NJIT-Solar-Car/canio/README.md

# CAN IO Board Development

# The CAN I/O driver board will allow the Central Control Unit to switch on and off various electronics over the vehicle’s CAN bus.
