NJIT-Solar-Car/canio/docs/DesignNotes.md

# CAN-IO Board Hardware/Firmware Development

- [Main Github][01]

## Fabrication notes

- Board is 4 layer, 100mm\*100mm
- It should be set to 1.6mm, using the FR4 TG135 (default) core, and JLC04161H-7628 stackup from JLCPCB.
- Outer copper weight should be *1oz* and inner copper weight *0.5oz* (not the 2oz and 1oz which the design centered around earlier). This allows a maximum **2A current draw** from each output channel.
- If possible, order the stencil as well
- Use DHL or FedEx shipping, the Global standard direct line is cheap but takes upwards of 2 weeks for shipping alone.
- Rough total, including stencil, board, shipping, and tariffs should be **~$50-70**.

<!-- Links -->
[01]: https://github.com/NJIT-Solar-Car/can-io-board
