NJIT-Solar-Car/canio/assets/CubeMX_Config.png

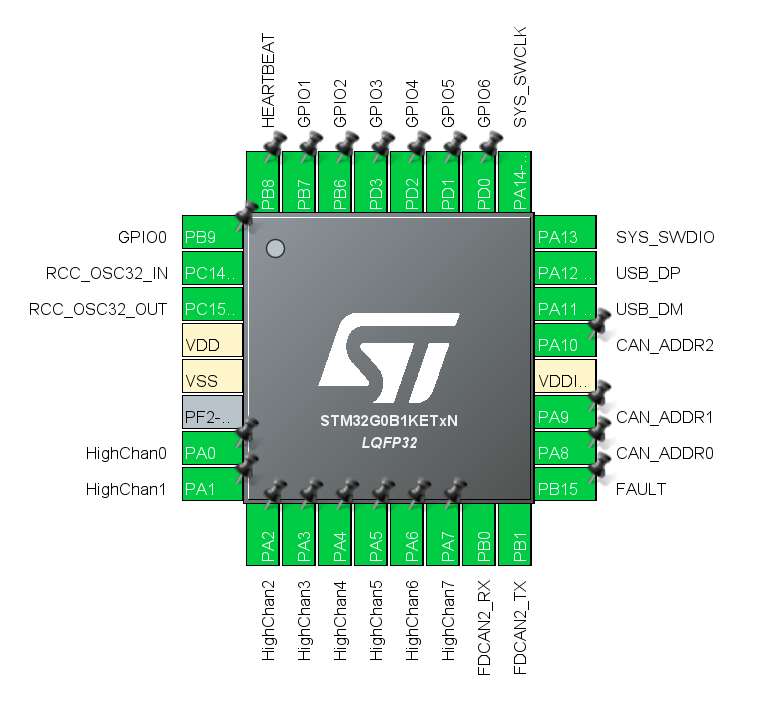
assets/CubeMX_Config.png
