NJIT-Solar-Car/canio/assets/relay_board_v1.png

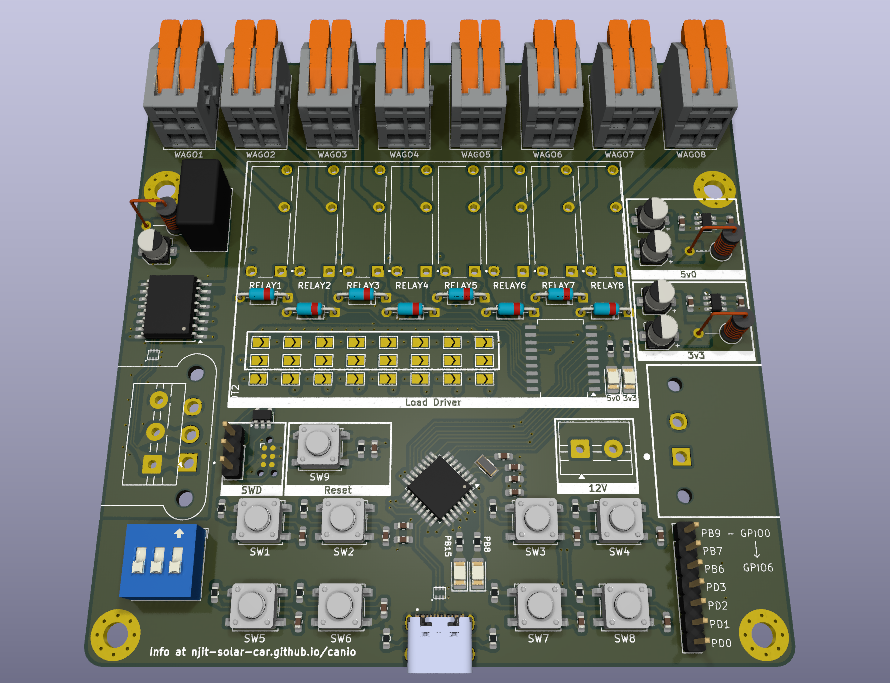
assets/relay_board_v1.png
