NJIT-Solar-Car/canio/assets/Relay_Schematic.gif

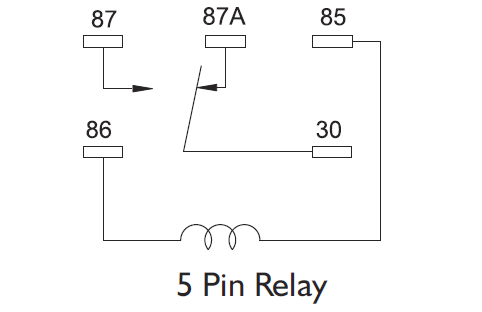
assets/Relay_Schematic.gif
