NJIT-Solar-Car/canio/Hardware/Relay/3DModels/2601-1102.stp

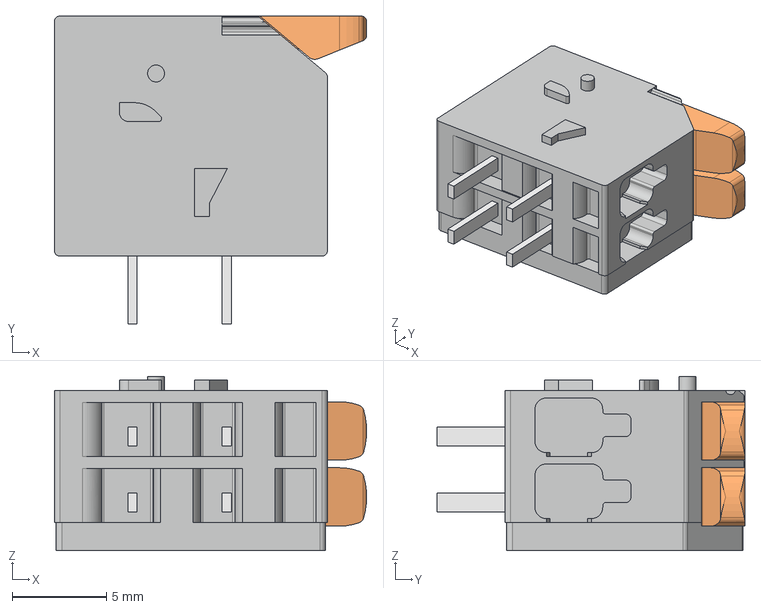
[picture p5: CAD file, 2026-06-16]
Hardware/Relay/3DModels/2601-1102.stp
16.6 x 16.4 x 9.25 mm
