NJIT-Solar-Car/canio/Hardware/Relay/3DModels/NME1S.step

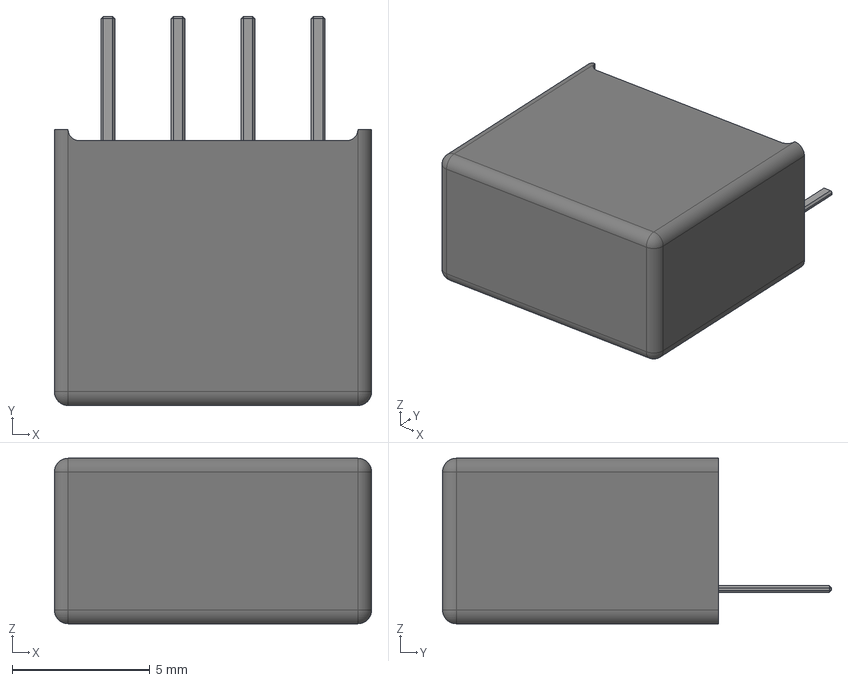
[picture p6: CAD file, 2026-06-16]
Hardware/Relay/3DModels/NME1S.step
11.5 x 14.1 x 6.00 mm
