NJIT-Solar-Car/canio/Hardware/Relay/3DModels/TL3301AF160QG.STEP

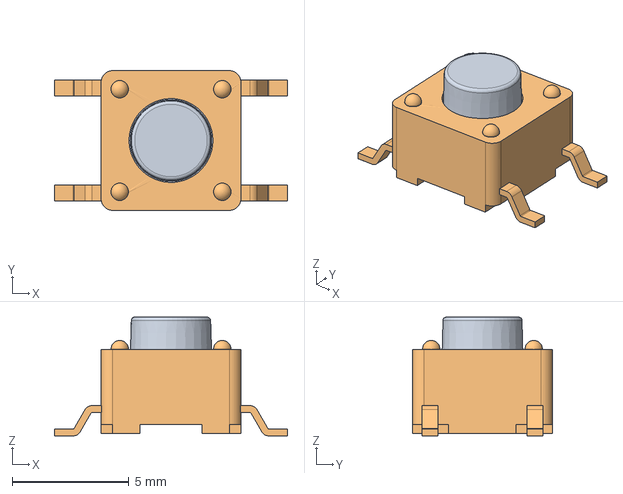
[picture p7: CAD file, 2026-06-16]
Hardware/Relay/3DModels/TL3301AF160QG.STEP
10.0 x 6.00 x 5.10 mm
