NJIT-Solar-Car/canio/Hardware/Relay/3DModels/USB4105GFA120--3DModel-STEP-56544.STEP

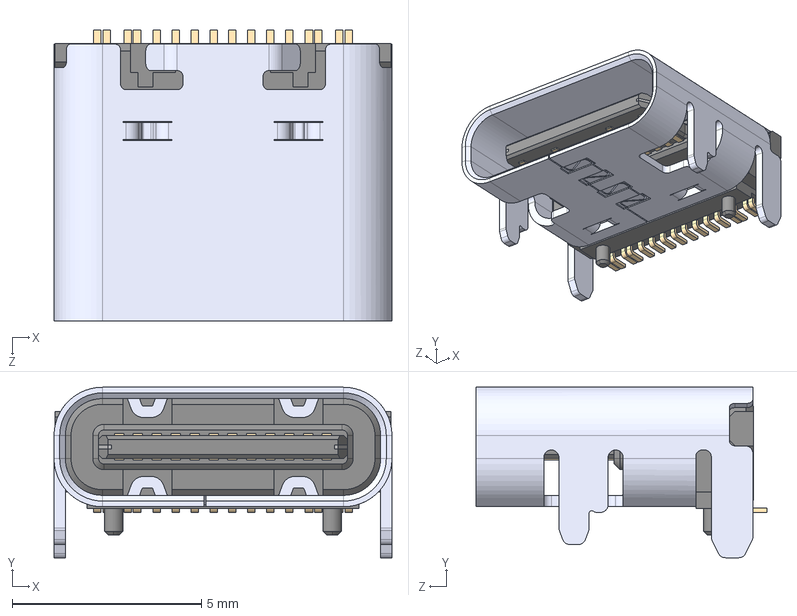
[picture p8: CAD file, 2026-06-16]
Hardware/Relay/3DModels/USB4105GFA120--3DModel-STEP-56544.STEP
8.94 x 4.51 x 7.71 mm
