NJIT-Solar-Car/canio/Hardware/Relay/3DModels/TPL7407LADR.step

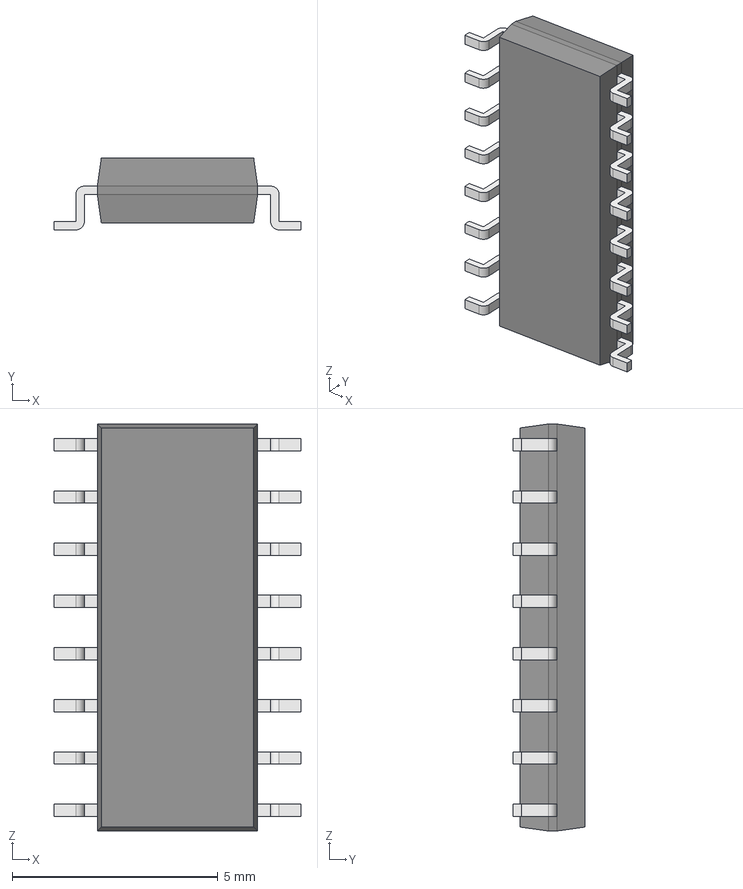
[picture p9: CAD file, 2026-06-09]
Hardware/Relay/3DModels/TPL7407LADR.step
6.00 x 1.75 x 9.90 mm
Body001 (Mirror #1) x 8
XY-plane x 12
X-axis x 12
