NJIT-Solar-Car/canio/Hardware/Relay/3DModels/VCF4-1000.step

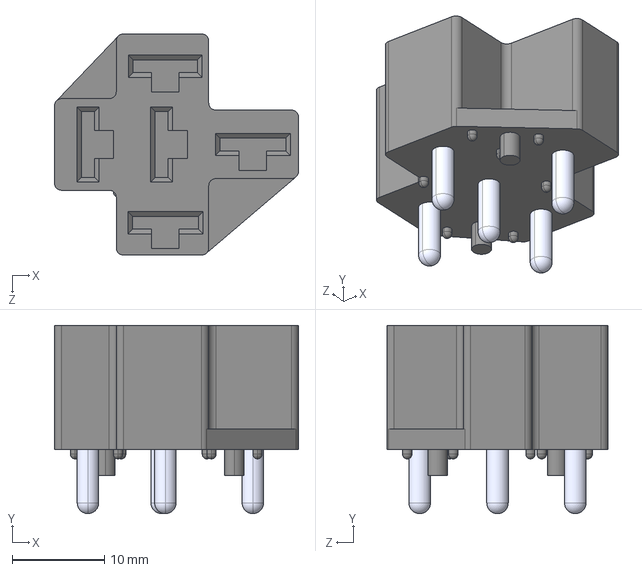
[picture p10: CAD file, 2026-06-09]
Hardware/Relay/3DModels/VCF4-1000.step
26.5 x 20.4 x 24.0 mm
