NJIT-Solar-Car/canio/(list of files, cad)

Other CAD files:
Hardware/Relay/3DModels/FreeCAD/NME1S.FCStd
