NJIT-Solar-Car/canio/Hardware/Relay/CANIO_Relay_Schematic.pdf

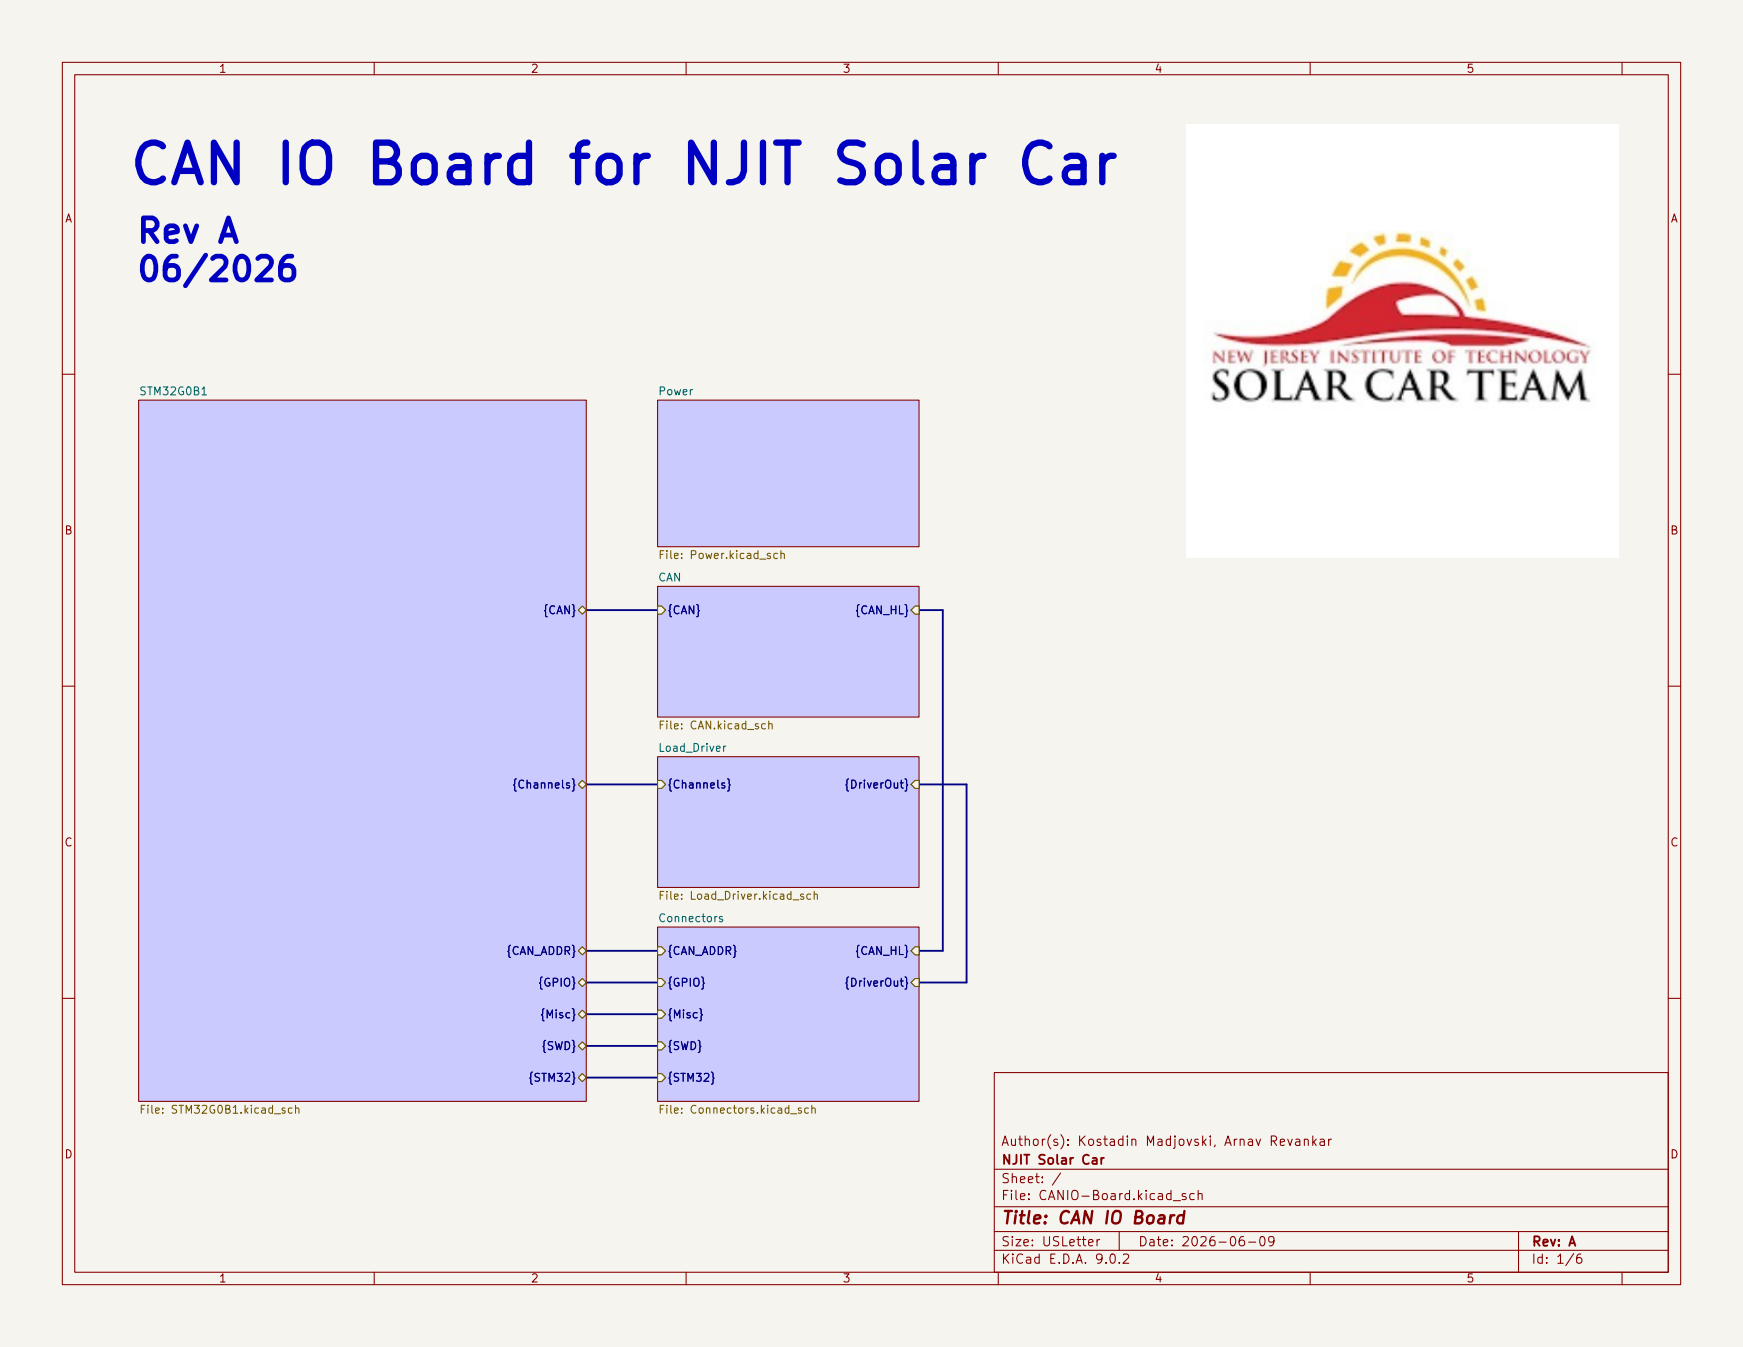
[picture p11: page 1]

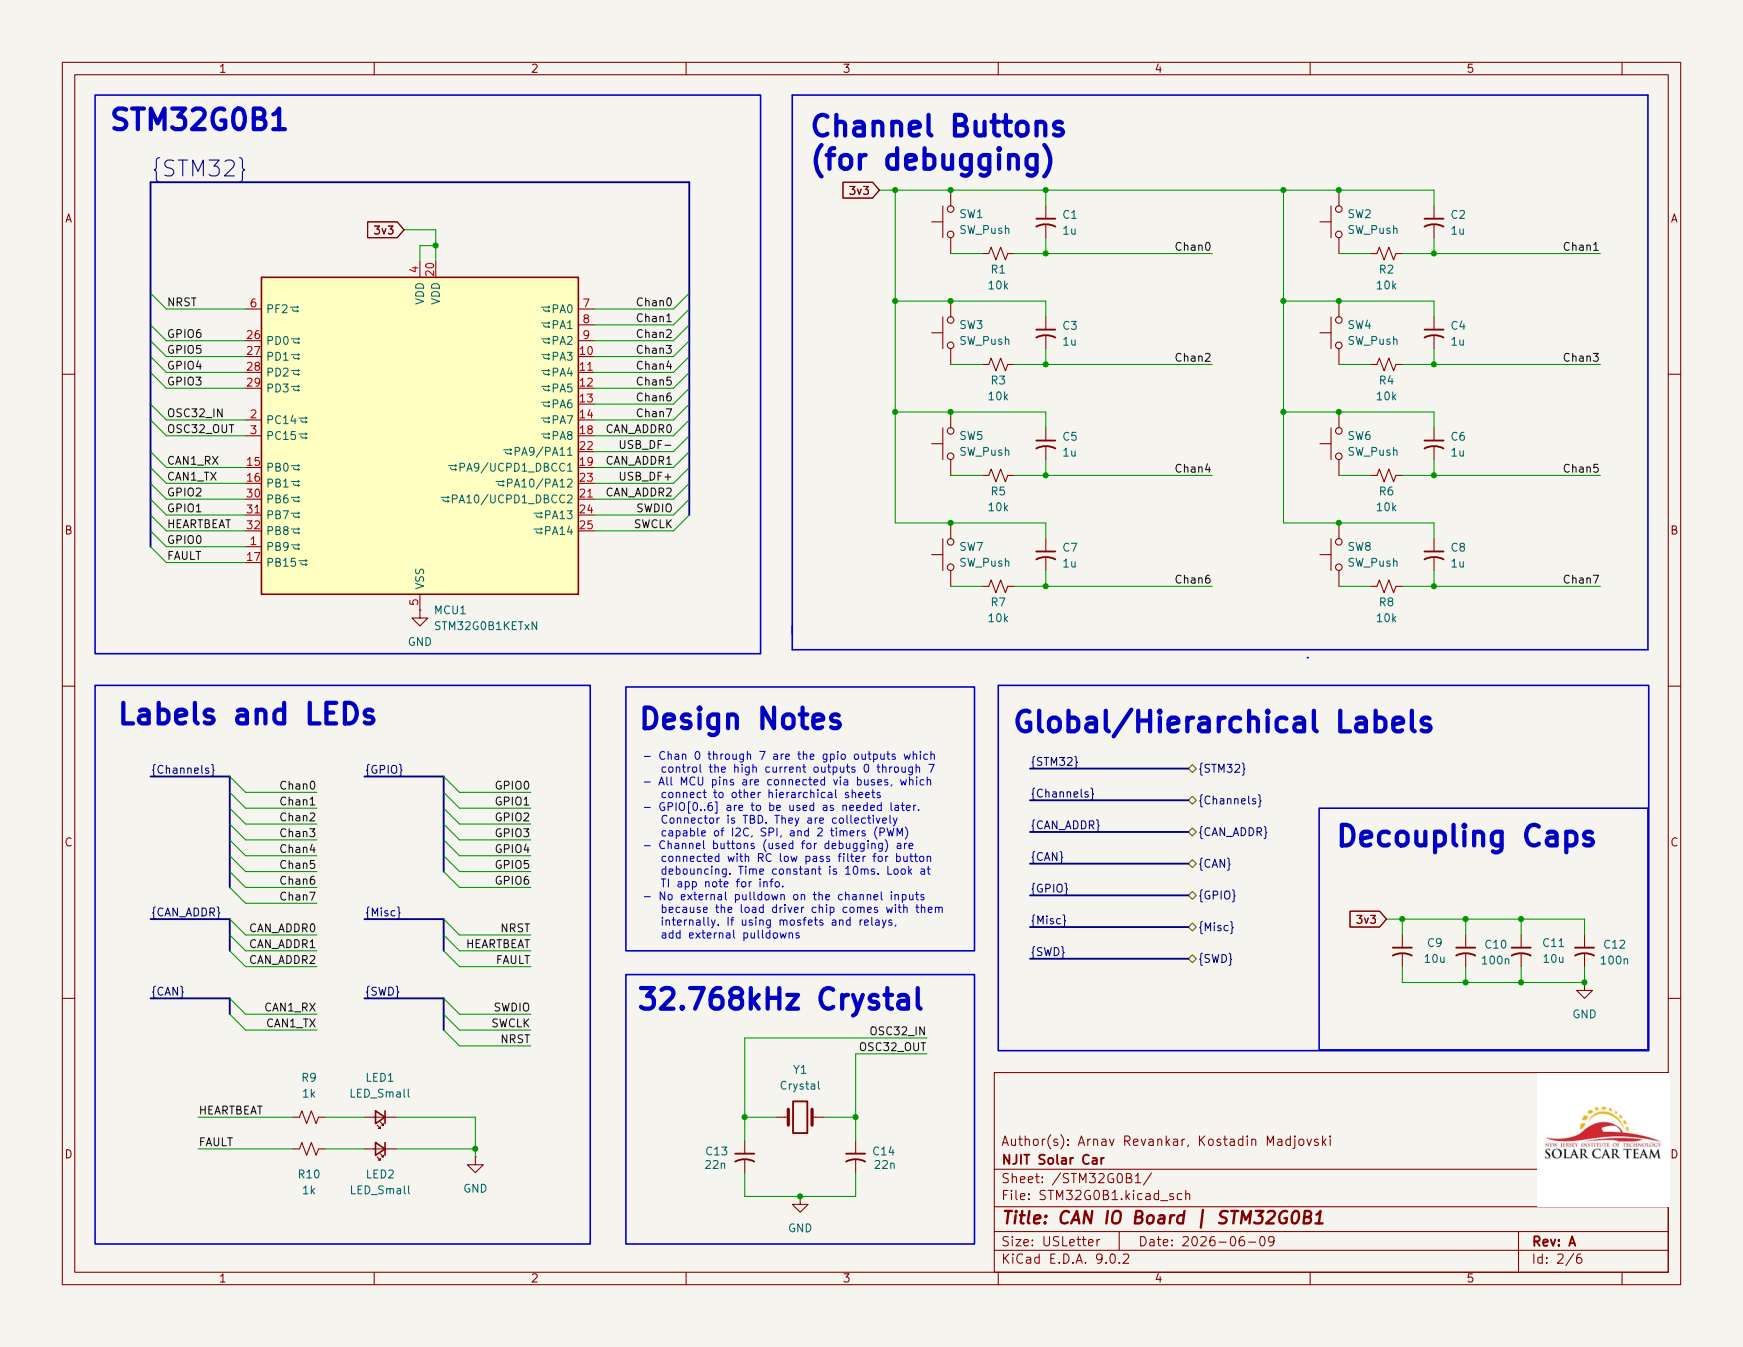
[picture p12: page 2]

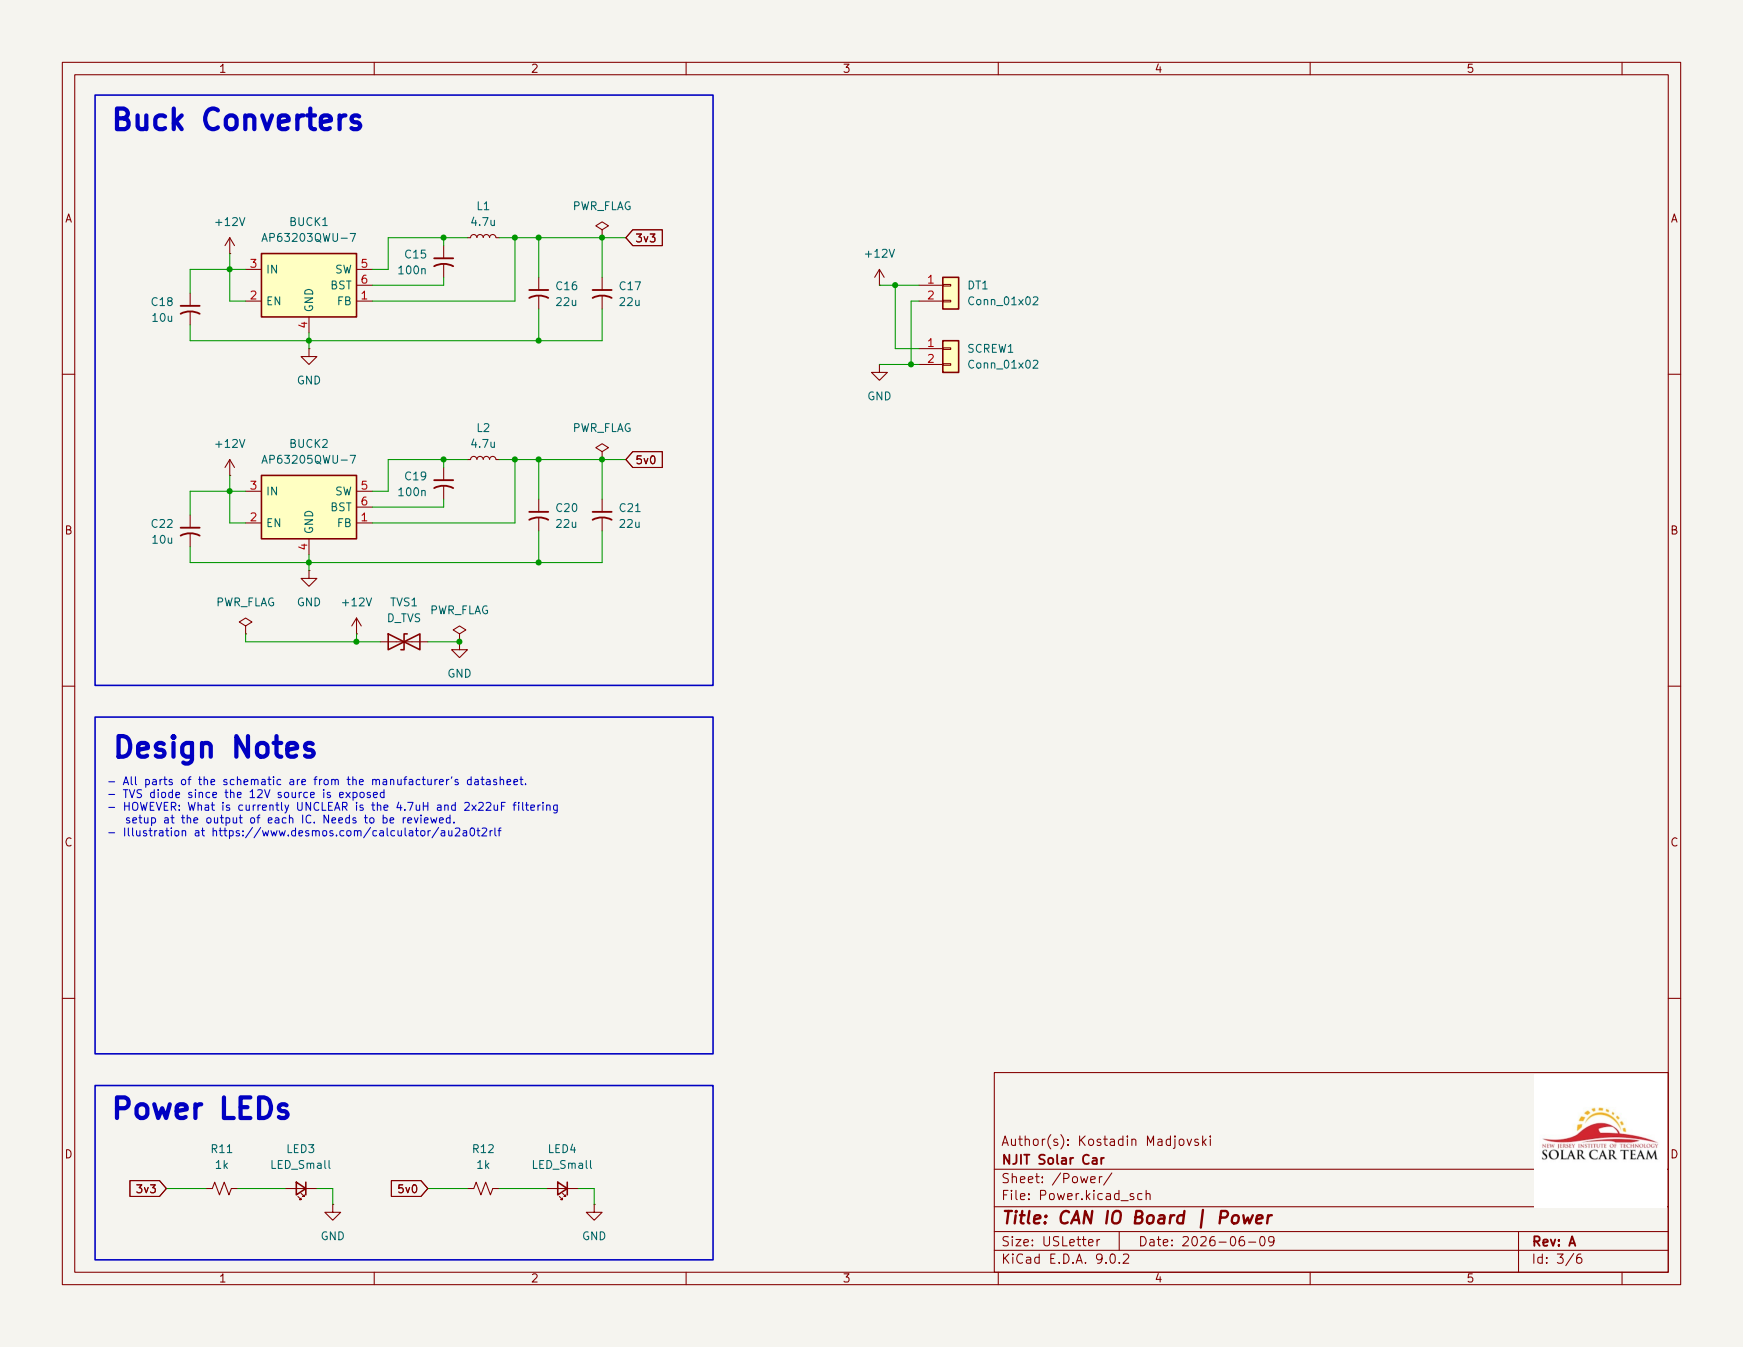
[picture p13: page 3]

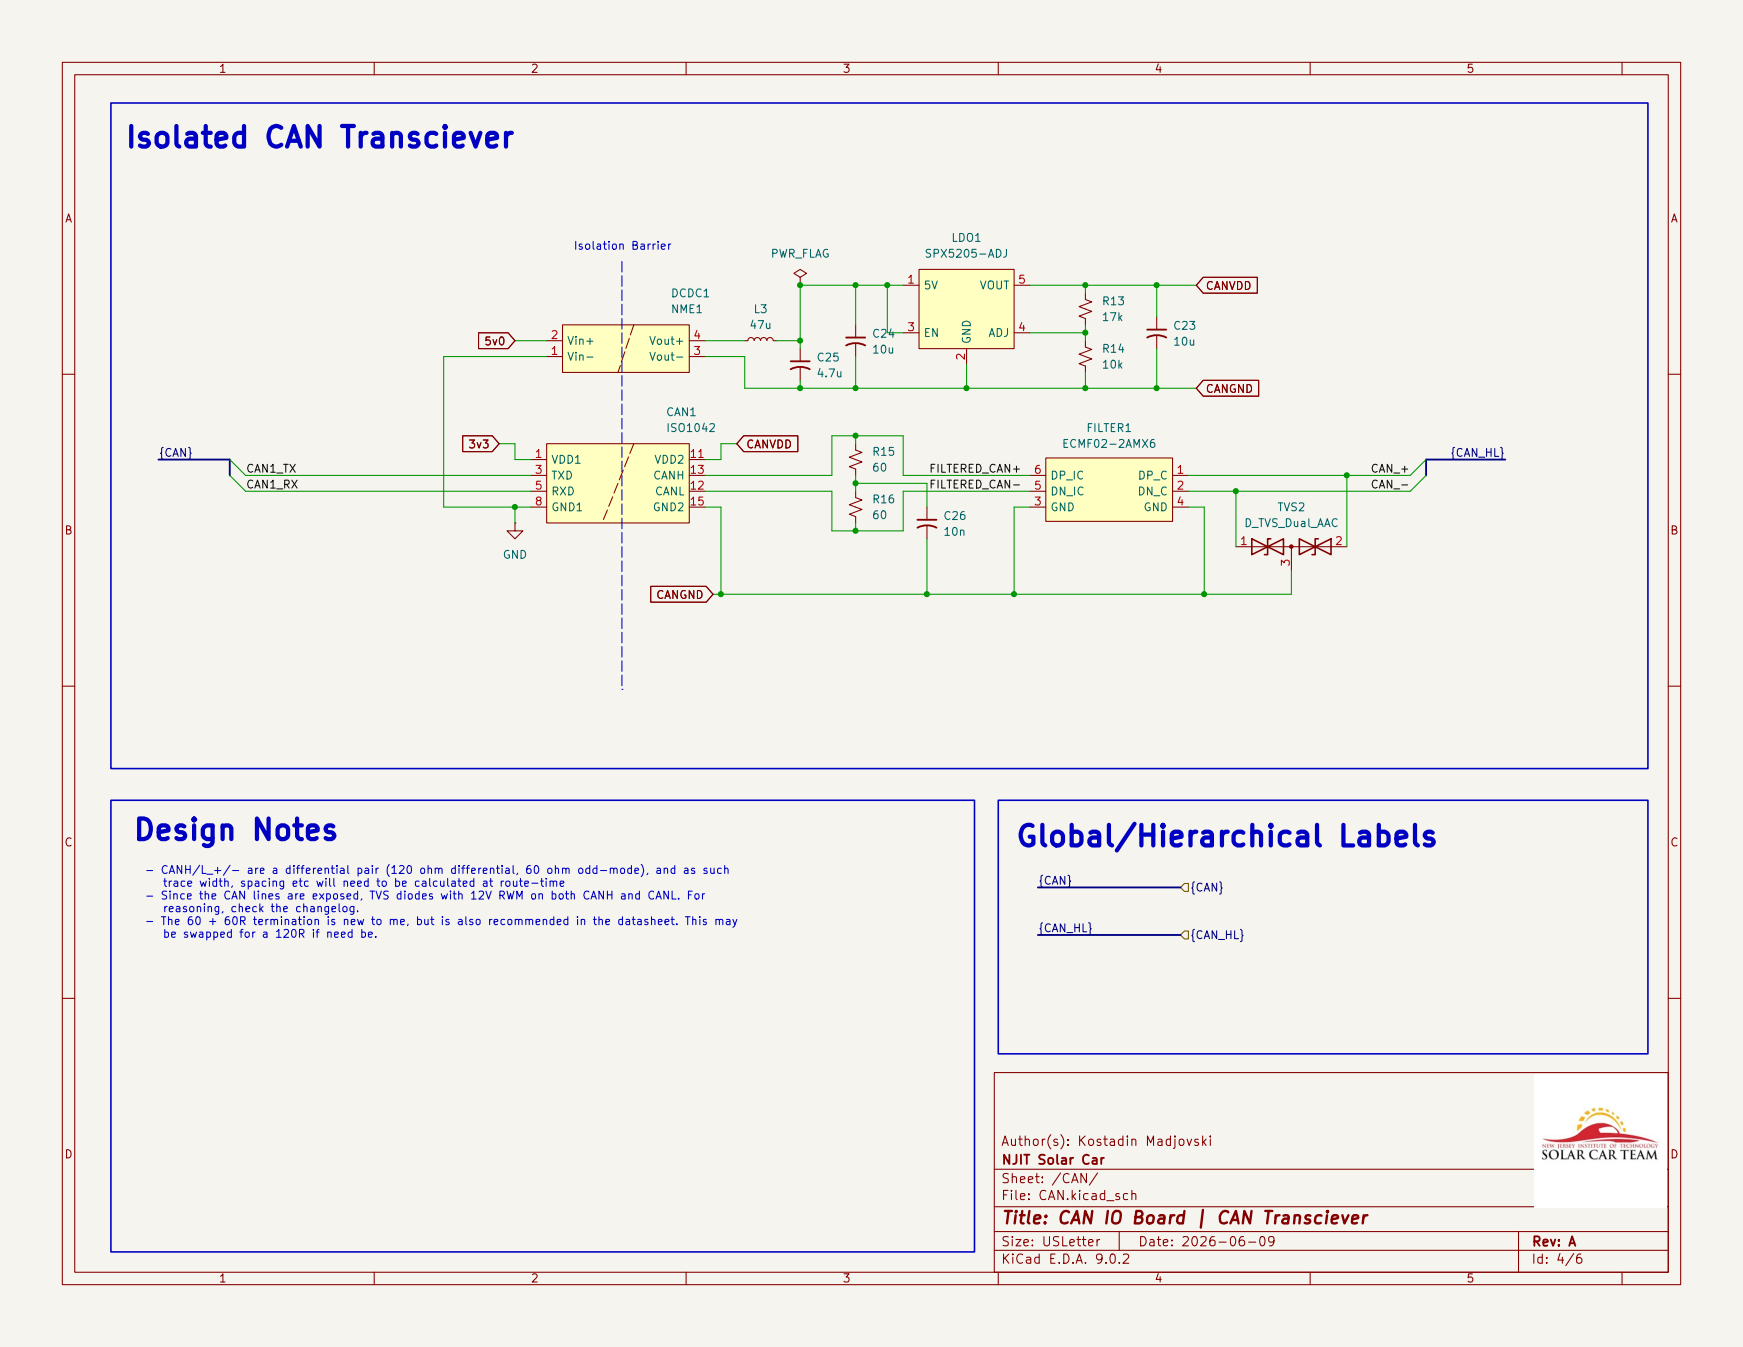
[picture p14: page 4]

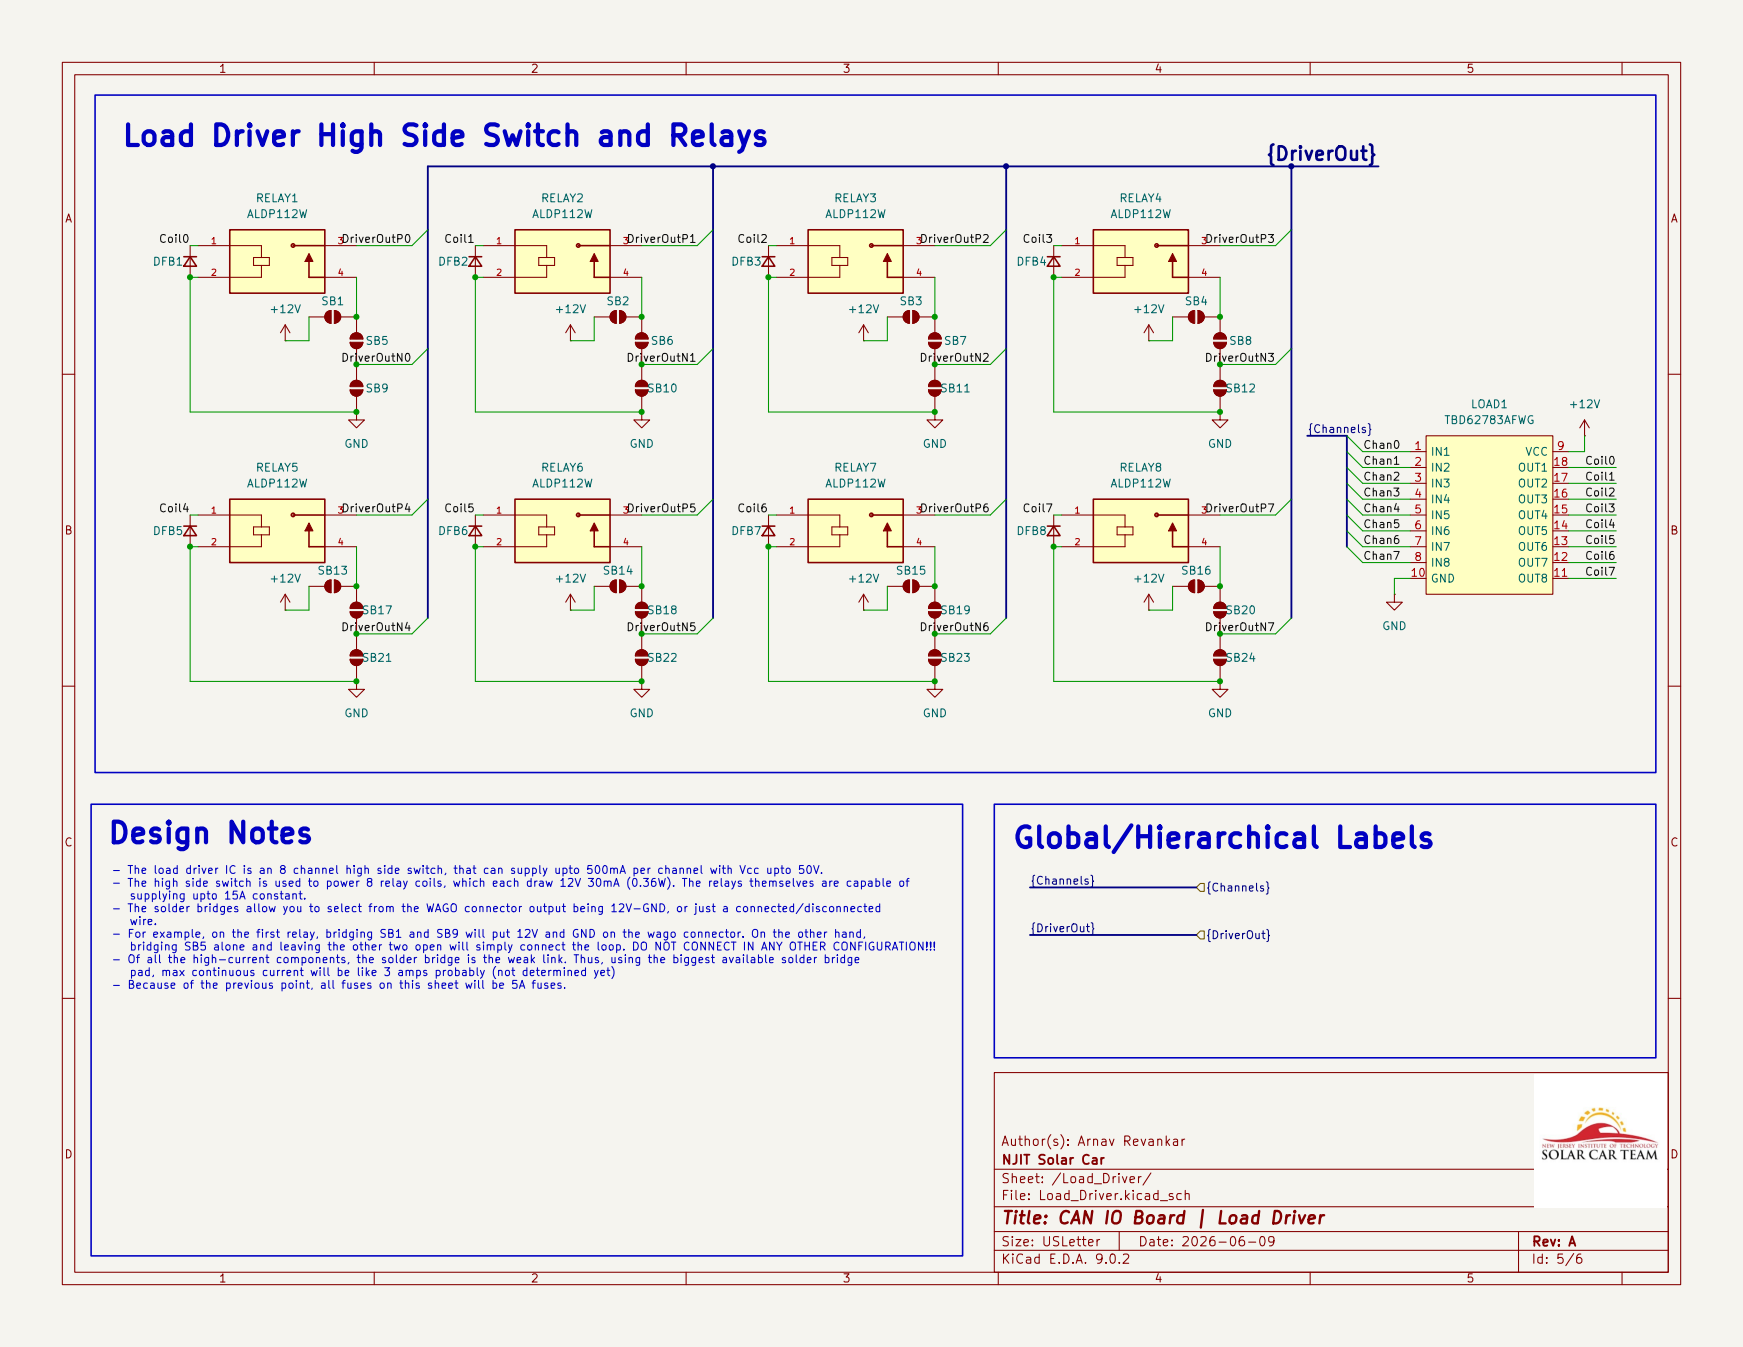
[picture p15: page 5]

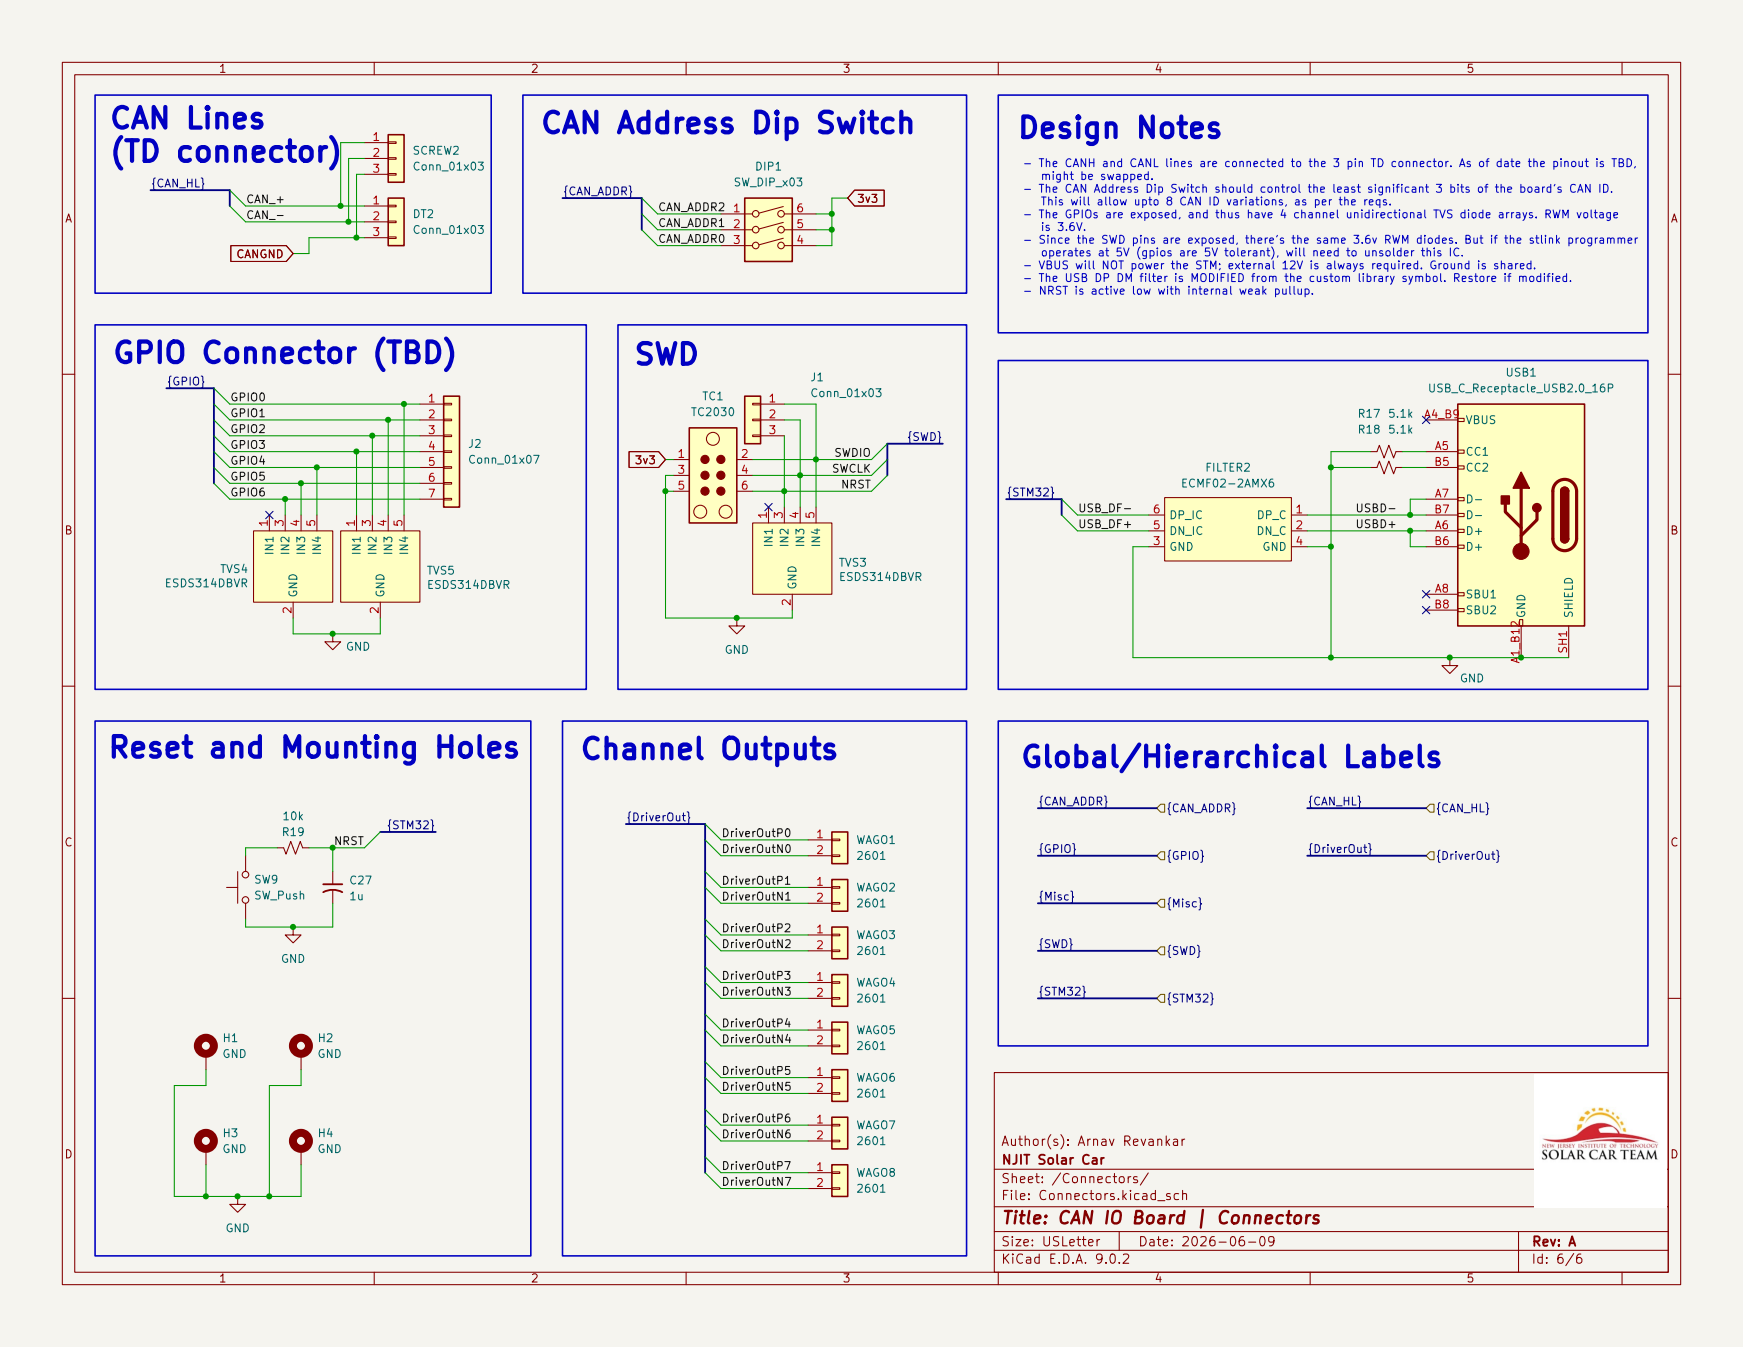
[picture p16: page 6]

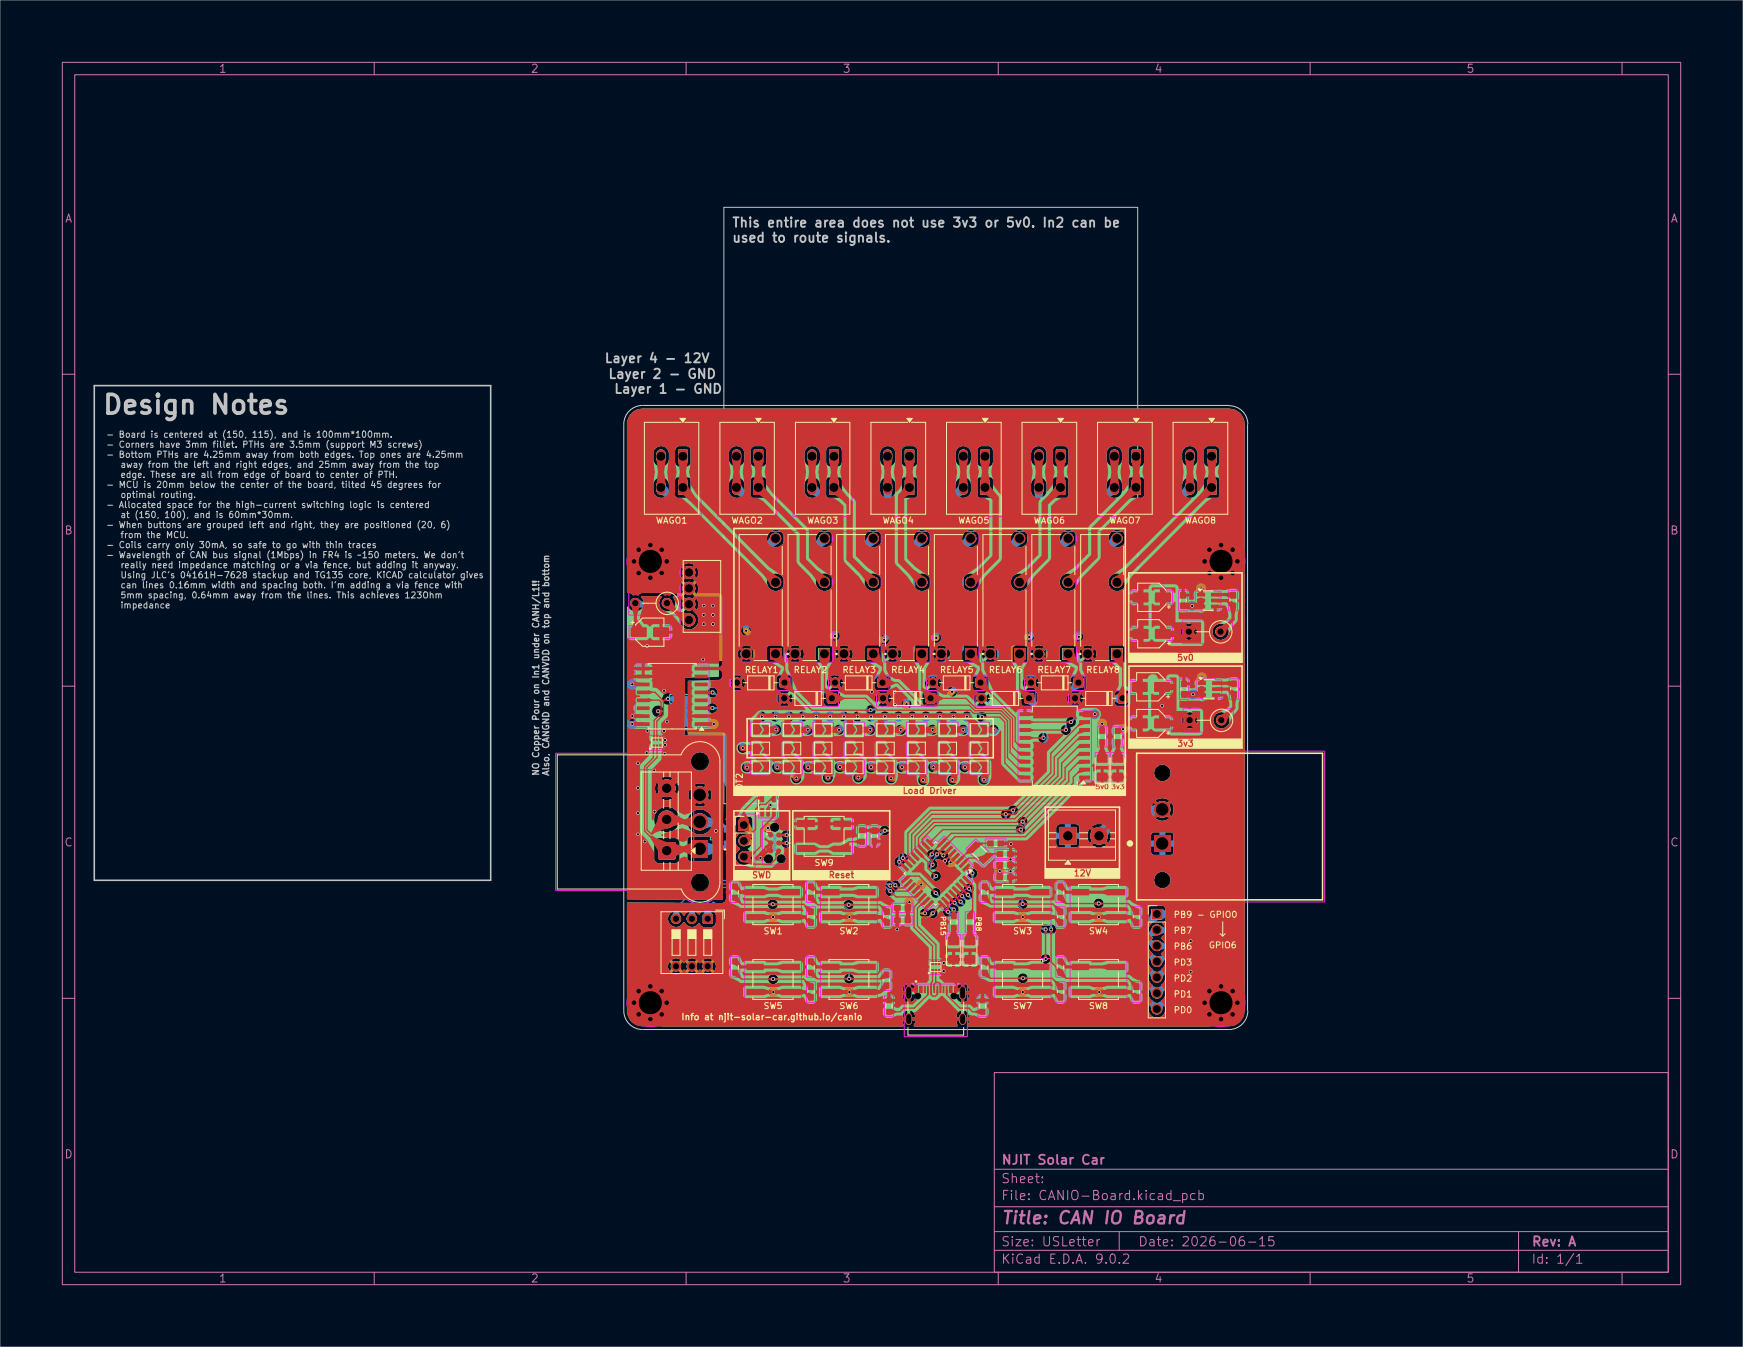
[picture p17: page 7]

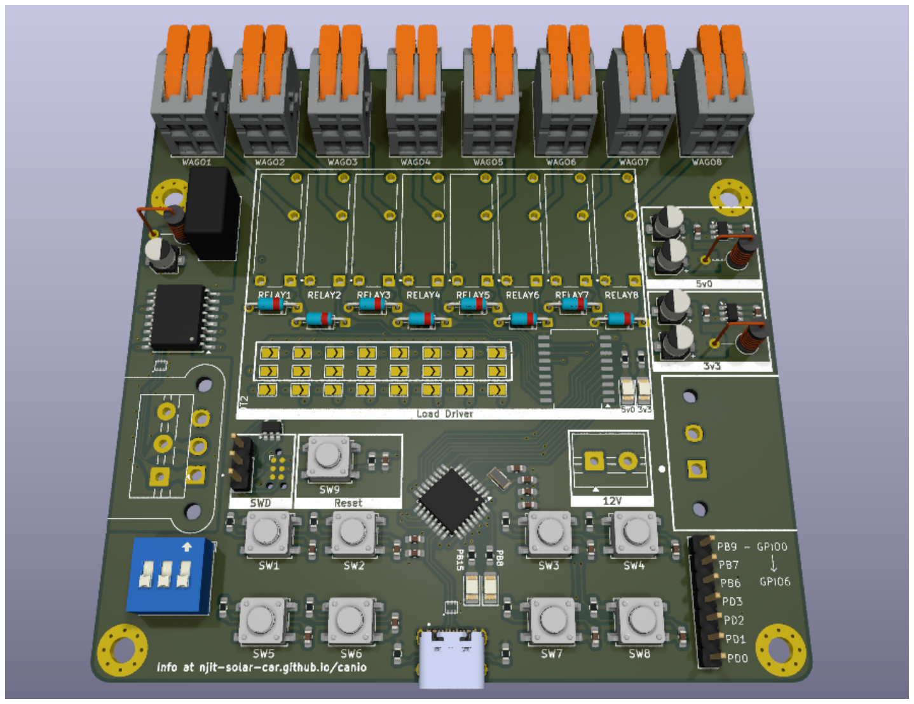
[picture p18: page 8]
