NJIT-Solar-Car/canio/Hardware/Relay/CANIO-Board.kicad_pcb

## KiCad design Hardware/Relay/CANIO-Board.kicad_pcb (2026-06-16)

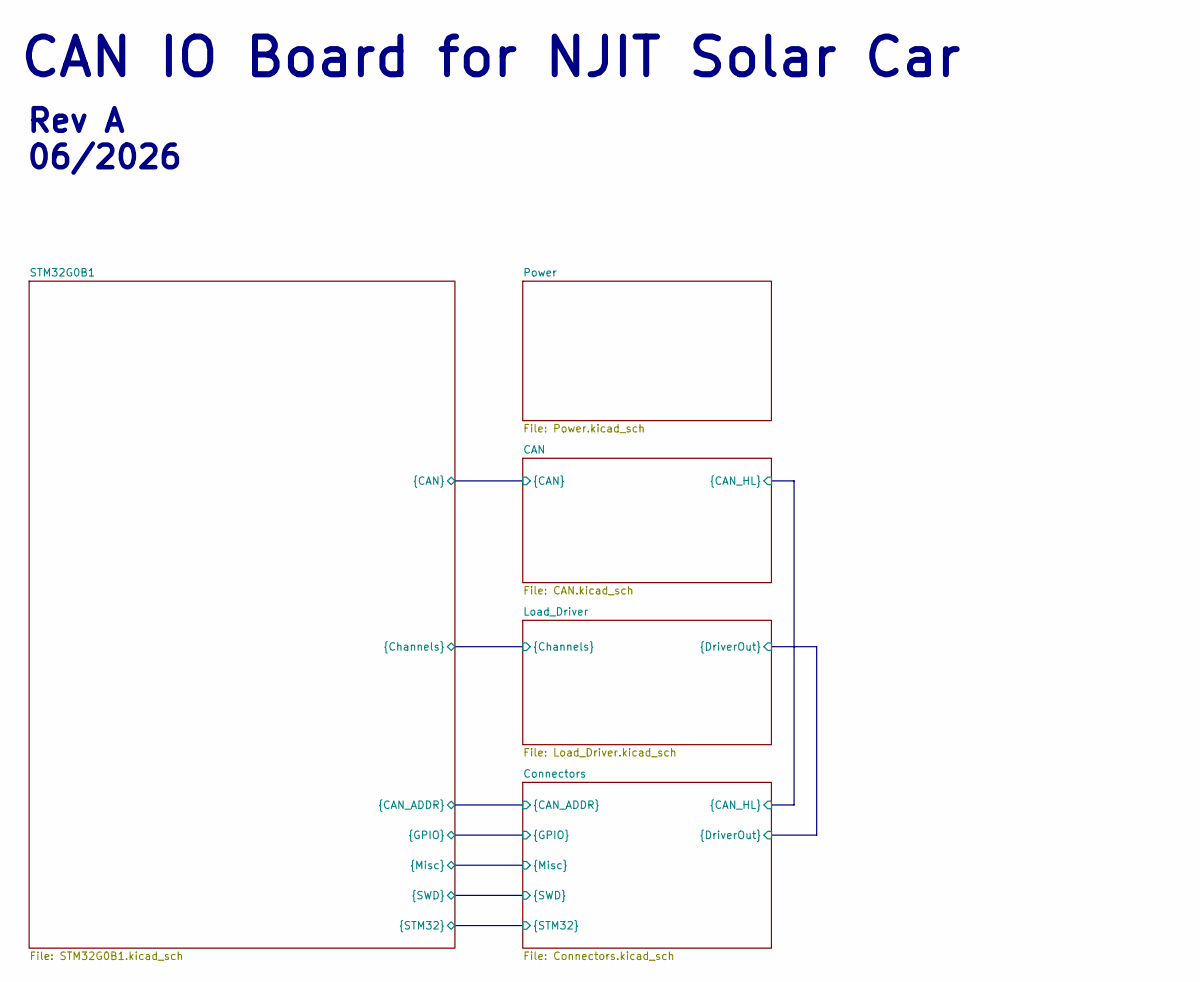
[picture p19: schematic CANIO-Board.kicad_sch, CAN IO Board]

Notes on the sheet:
CAN IO Board for NJIT Solar Car
Rev A 06/2026

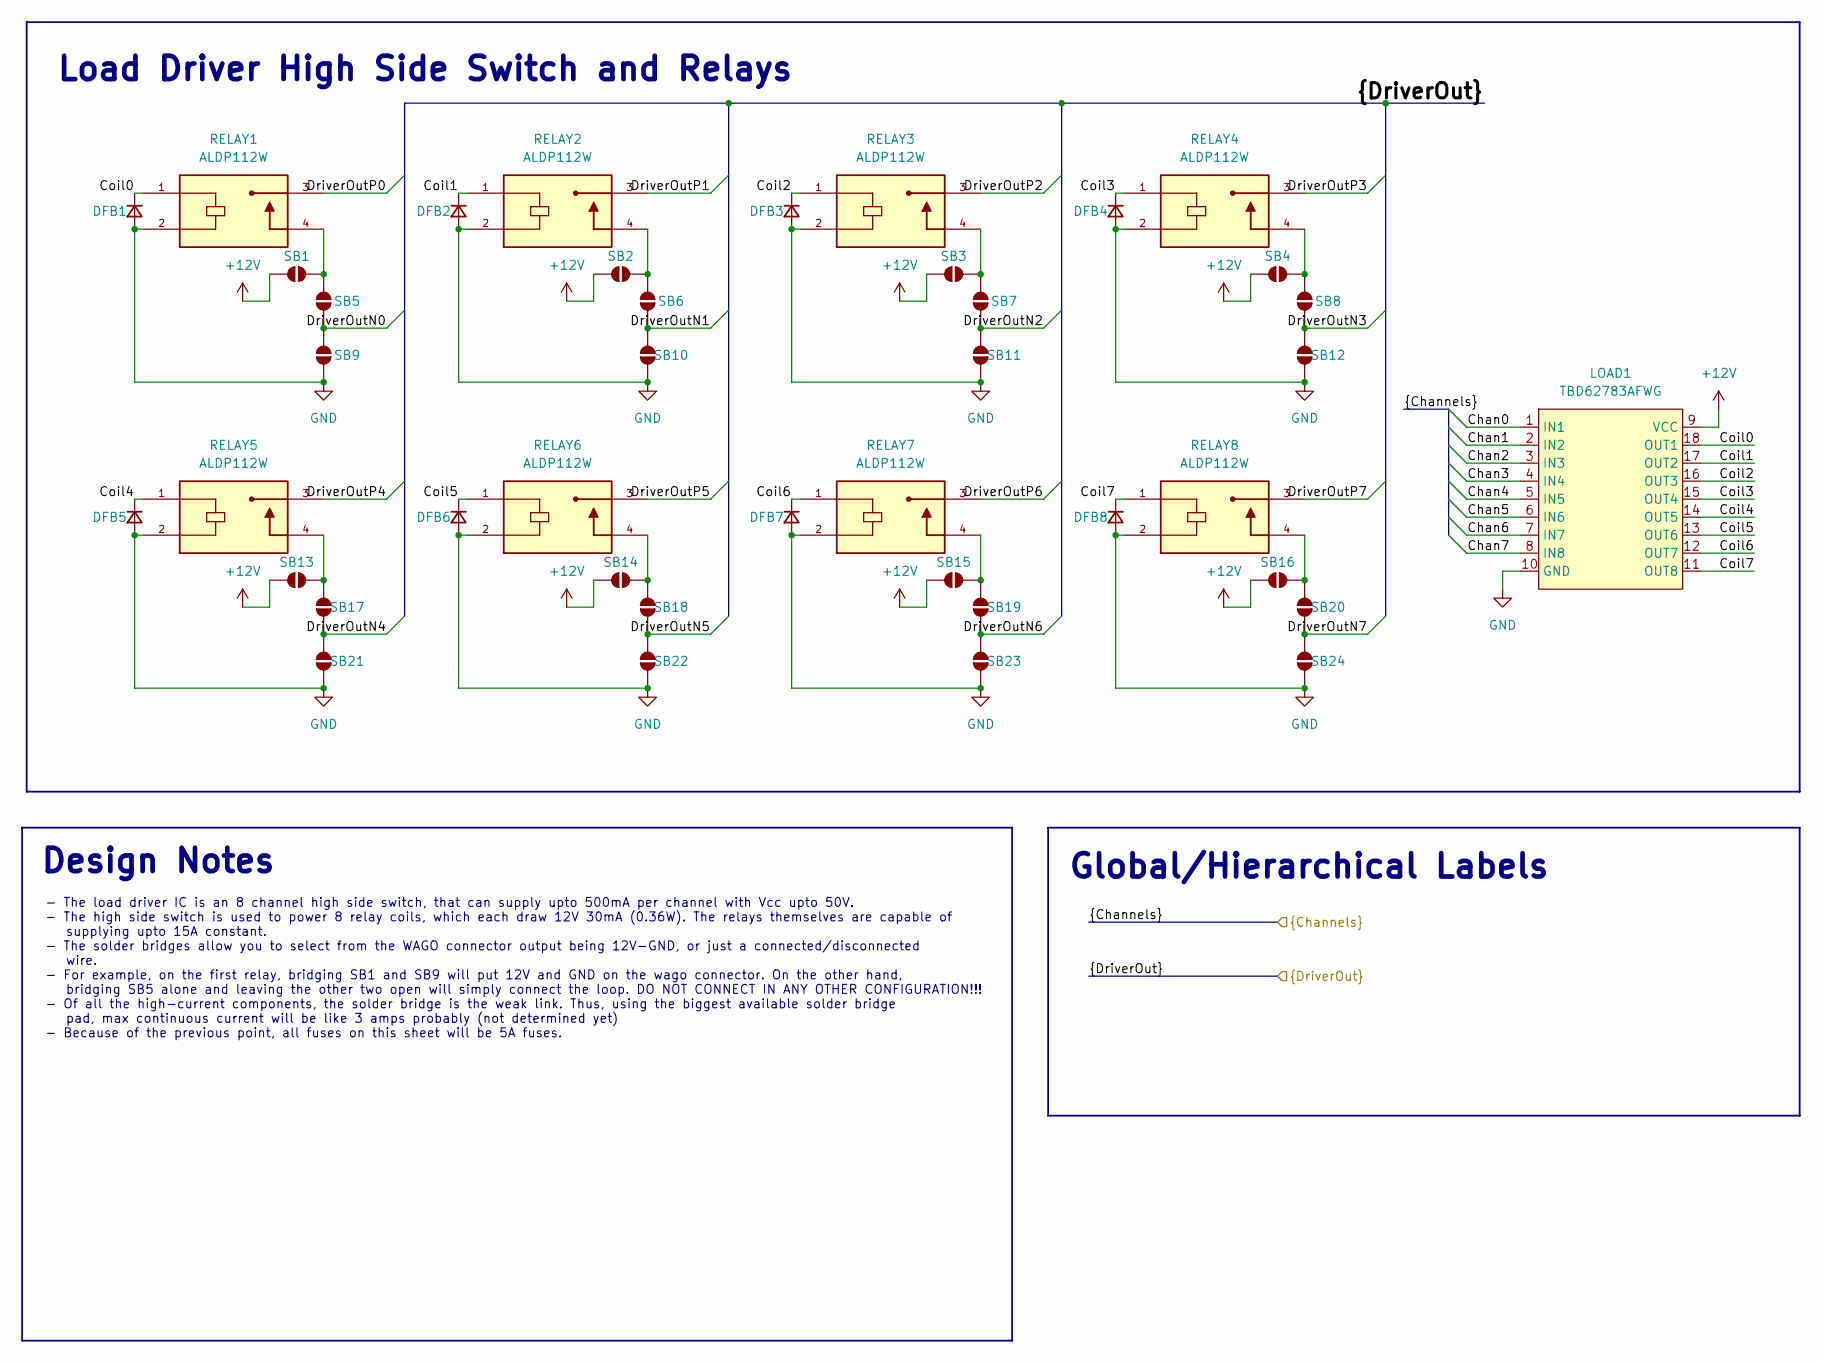
[picture p20: schematic Load_Driver.kicad_sch, CAN IO Board | Load Driver]

Parts:
DFB1, DFB2, DFB3, DFB4, DFB5, DFB6, DFB7, DFB8: D_Small; D_DO-35_SOD27_P7.62mm_Horizontal
LOAD1: TBD62783AFWG; SOP-18_7x12.5mm_P1.27mm
RELAY1, RELAY2, RELAY3, RELAY4, RELAY5, RELAY6, RELAY7, RELAY8: ALDP112W; RELAY_ALDP112W; PARTREV 2024.10
SB1, SB2, SB3, SB4, SB5, SB6, SB7, SB8, SB9, SB10, SB11, SB12, SB13, SB14, SB15, SB16, SB17, SB18, SB19, SB20, SB21, SB22, SB23, SB24: SolderJumper_2_Open; SolderJumper-2_P1.3mm_Open_TrianglePad1.0x1.5mm

Connections:
+12V: LOAD1.9 (VCC), SB1.1 (A), SB2.1 (A), SB3.1 (A), SB4.1 (A), SB13.1 (A), SB14.1 (A), SB15.1 (A), SB16.1 (A); also elsewhere on the board
/Connectors/DriverOutN0: SB5.2 (B), SB9.1 (A); also elsewhere on the board
/Connectors/DriverOutN1: SB6.2 (B), SB10.1 (A); also elsewhere on the board
/Connectors/DriverOutN2: SB7.2 (B), SB11.1 (A); also elsewhere on the board
/Connectors/DriverOutN3: SB8.2 (B), SB12.1 (A); also elsewhere on the board
/Connectors/DriverOutN4: SB17.2 (B), SB21.1 (A); also elsewhere on the board
/Connectors/DriverOutN5: SB18.2 (B), SB22.1 (A); also elsewhere on the board
/Connectors/DriverOutN6: SB19.2 (B), SB23.1 (A); also elsewhere on the board
/Connectors/DriverOutN7: SB20.2 (B), SB24.1 (A); also elsewhere on the board
/Connectors/DriverOutP0: RELAY1.3; also elsewhere on the board
/Connectors/DriverOutP1: RELAY2.3; also elsewhere on the board
/Connectors/DriverOutP2: RELAY3.3; also elsewhere on the board
/Connectors/DriverOutP3: RELAY4.3; also elsewhere on the board
/Connectors/DriverOutP4: RELAY5.3; also elsewhere on the board
/Connectors/DriverOutP5: RELAY6.3; also elsewhere on the board
/Connectors/DriverOutP6: RELAY7.3; also elsewhere on the board
/Connectors/DriverOutP7: RELAY8.3; also elsewhere on the board
/Load_Driver/Chan0: LOAD1.1 (IN1); also elsewhere on the board
/Load_Driver/Chan1: LOAD1.2 (IN2); also elsewhere on the board
/Load_Driver/Chan2: LOAD1.3 (IN3); also elsewhere on the board
/Load_Driver/Chan3: LOAD1.4 (IN4); also elsewhere on the board
/Load_Driver/Chan4: LOAD1.5 (IN5); also elsewhere on the board
/Load_Driver/Chan5: LOAD1.6 (IN6); also elsewhere on the board
/Load_Driver/Chan6: LOAD1.7 (IN7); also elsewhere on the board
/Load_Driver/Chan7: LOAD1.8 (IN8); also elsewhere on the board
/Load_Driver/Coil0: DFB1.1 (K), LOAD1.18 (OUT1), RELAY1.1
/Load_Driver/Coil1: DFB2.1 (K), LOAD1.17 (OUT2), RELAY2.1
/Load_Driver/Coil2: DFB3.1 (K), LOAD1.16 (OUT3), RELAY3.1
/Load_Driver/Coil3: DFB4.1 (K), LOAD1.15 (OUT4), RELAY4.1
/Load_Driver/Coil4: DFB5.1 (K), LOAD1.14 (OUT5), RELAY5.1
/Load_Driver/Coil5: DFB6.1 (K), LOAD1.13 (OUT6), RELAY6.1
/Load_Driver/Coil6: DFB7.1 (K), LOAD1.12 (OUT7), RELAY7.1
/Load_Driver/Coil7: DFB8.1 (K), LOAD1.11 (OUT8), RELAY8.1
GND: DFB1.2 (A), DFB2.2 (A), DFB3.2 (A), DFB4.2 (A), DFB5.2 (A), DFB6.2 (A), DFB7.2 (A), DFB8.2 (A), LOAD1.10 (GND), RELAY1.2, RELAY2.2, RELAY3.2, RELAY4.2, RELAY5.2, RELAY6.2, RELAY7.2, RELAY8.2, SB9.2 (B), SB10.2 (B), SB11.2 (B), SB12.2 (B), SB21.2 (B), SB22.2 (B), SB23.2 (B), SB24.2 (B); also elsewhere on the board
unnamed: RELAY1.4, SB1.2 (B), SB5.1 (A)
unnamed: RELAY2.4, SB2.2 (B), SB6.1 (A)
unnamed: RELAY3.4, SB3.2 (B), SB7.1 (A)
unnamed: RELAY4.4, SB4.2 (B), SB8.1 (A)
unnamed: RELAY5.4, SB13.2 (B), SB17.1 (A)
unnamed: RELAY6.4, SB14.2 (B), SB18.1 (A)
unnamed: RELAY7.4, SB15.2 (B), SB19.1 (A)
unnamed: RELAY8.4, SB16.2 (B), SB20.1 (A)

Notes on the sheet:
Design Notes
Load Driver High Side Switch and Relays
- The load driver IC is an 8 channel high side switch, that can supply upto 500mA per channel with Vcc upto 50V. - The high side switch is used to power 8 relay coils, which each draw 12V 30mA (0.36W). The relays themselves are capable of supplying upto 15A constant. - The solder bridges allow you 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
Global/Hierarchical Labels

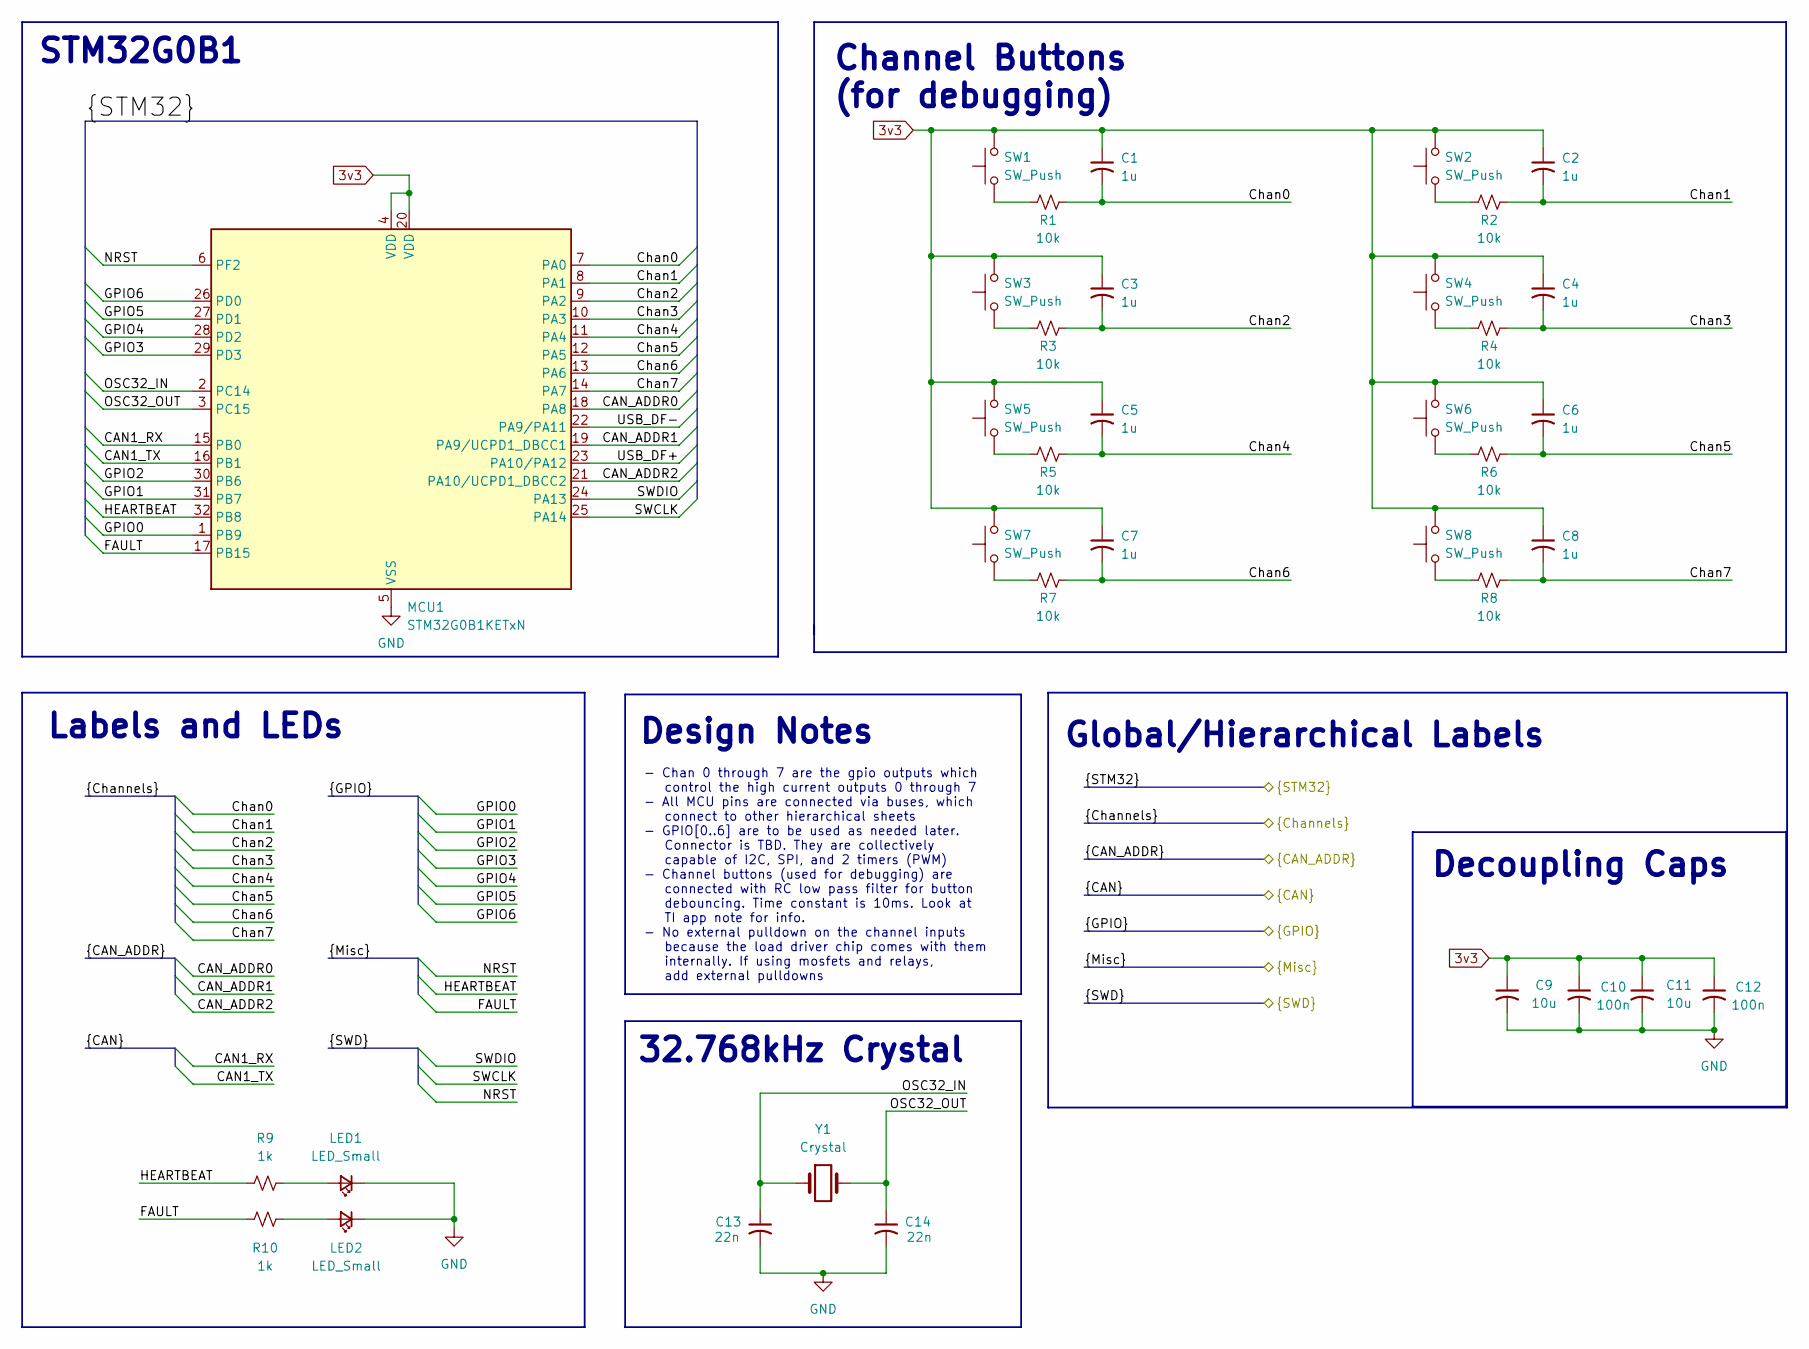
[picture p21: schematic STM32G0B1.kicad_sch, CAN IO Board | STM32G0B1]

Parts:
C1, C2, C3, C4, C5, C6, C7, C8: 1u; C_0603_1608Metric_Pad1.08x0.95mm_HandSolder
C9, C11: 10u; C_0603_1608Metric_Pad1.08x0.95mm_HandSolder
C10, C12: 100n; C_0603_1608Metric_Pad1.08x0.95mm_HandSolder
C13, C14: 22n; C_0603_1608Metric_Pad1.08x0.95mm_HandSolder
LED1, LED2: LED_Small; LED_1206_3216Metric_Pad1.42x1.75mm_HandSolder
MCU1: STM32G0B1KETxN; LQFP-32_7x7mm_P0.8mm
R1, R2, R3, R4, R5, R6, R7, R8: 10k; R_0603_1608Metric_Pad0.98x0.95mm_HandSolder
R9, R10: 1k; R_0603_1608Metric_Pad0.98x0.95mm_HandSolder
SW1, SW2, SW3, SW4, SW5, SW6, SW7, SW8: SW_Push; SW_Push_1P1T_NO_CK_KSC7xxJ
Y1: Crystal; Crystal_SMD_3215-2Pin_3.2x1.5mm

Connections:
3v3: C1.1, C2.1, C3.1, C4.1, C5.1, C6.1, C7.1, C8.1, C9.1, C10.1, C11.1, C12.1, MCU1.4 (VDD), MCU1.20 (VDD), SW1.2, SW2.2, SW3.2, SW4.2, SW5.2, SW6.2, SW7.2, SW8.2; also elsewhere on the board
/CAN/CAN1_RX: MCU1.15 (PB0); also elsewhere on the board
/CAN/CAN1_TX: MCU1.16 (PB1); also elsewhere on the board
/Connectors/CAN_ADDR0: MCU1.18 (PA8); also elsewhere on the board
/Connectors/CAN_ADDR1: MCU1.19 (PA9/UCPD1_DBCC1); also elsewhere on the board
/Connectors/CAN_ADDR2: MCU1.21 (PA10/UCPD1_DBCC2); also elsewhere on the board
/Connectors/FAULT: MCU1.17 (PB15), R10.1
/Connectors/GPIO0: MCU1.1 (PB9); also elsewhere on the board
/Connectors/GPIO1: MCU1.31 (PB7); also elsewhere on the board
/Connectors/GPIO2: MCU1.30 (PB6); also elsewhere on the board
/Connectors/GPIO3: MCU1.29 (PD3); also elsewhere on the board
/Connectors/GPIO4: MCU1.28 (PD2); also elsewhere on the board
/Connectors/GPIO5: MCU1.27 (PD1); also elsewhere on the board
/Connectors/GPIO6: MCU1.26 (PD0); also elsewhere on the board
/Connectors/HEARTBEAT: MCU1.32 (PB8), R9.1
/Connectors/NRST: MCU1.6 (PF2); also elsewhere on the board
/Connectors/OSC32_IN: C13.1, MCU1.2 (PC14), Y1.1
/Connectors/OSC32_OUT: C14.1, MCU1.3 (PC15), Y1.2
/Connectors/SWCLK: MCU1.25 (PA14); also elsewhere on the board
/Connectors/SWDIO: MCU1.24 (PA13); also elsewhere on the board
/Connectors/USB_DF+: MCU1.23 (PA10/PA12); also elsewhere on the board
/Connectors/USB_DF-: MCU1.22 (PA9/PA11); also elsewhere on the board
/Load_Driver/Chan0: C1.2, MCU1.7 (PA0), R1.1; also elsewhere on the board
/Load_Driver/Chan1: C2.2, MCU1.8 (PA1), R2.1; also elsewhere on the board
/Load_Driver/Chan2: C3.2, MCU1.9 (PA2), R3.1; also elsewhere on the board
/Load_Driver/Chan3: C4.2, MCU1.10 (PA3), R4.1; also elsewhere on the board
/Load_Driver/Chan4: C5.2, MCU1.11 (PA4), R5.1; also elsewhere on the board
/Load_Driver/Chan5: C6.2, MCU1.12 (PA5), R6.1; also elsewhere on the board
/Load_Driver/Chan6: C7.2, MCU1.13 (PA6), R7.1; also elsewhere on the board
/Load_Driver/Chan7: C8.2, MCU1.14 (PA7), R8.1; also elsewhere on the board
GND: C9.2, C10.2, C11.2, C12.2, C13.2, C14.2, LED1.1 (K), LED2.1 (K), MCU1.5 (VSS); also elsewhere on the board
unnamed: LED1.2 (A), R9.2
unnamed: LED2.2 (A), R10.2
unnamed: R1.2, SW1.1
unnamed: R2.2, SW2.1
unnamed: R3.2, SW3.1
unnamed: R4.2, SW4.1
unnamed: R5.2, SW5.1
unnamed: R6.2, SW6.1
unnamed: R7.2, SW7.1
unnamed: R8.2, SW8.1

Notes on the sheet:
Labels and LEDs
32.768kHz Crystal
Channel Buttons (for debugging)
STM32G0B1
- Chan 0 through 7 are the gpio outputs which control the high current outputs 0 through 7 - All MCU pins are connected via buses, which connect to other hierarchical sheets - GPIO[0..6] are to be used as needed later. Connector is TBD. They are collectively capable of I2C, SPI, and 2 timers (PWM) 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
Global/Hierarchical Labels
Decoupling Caps
Design Notes

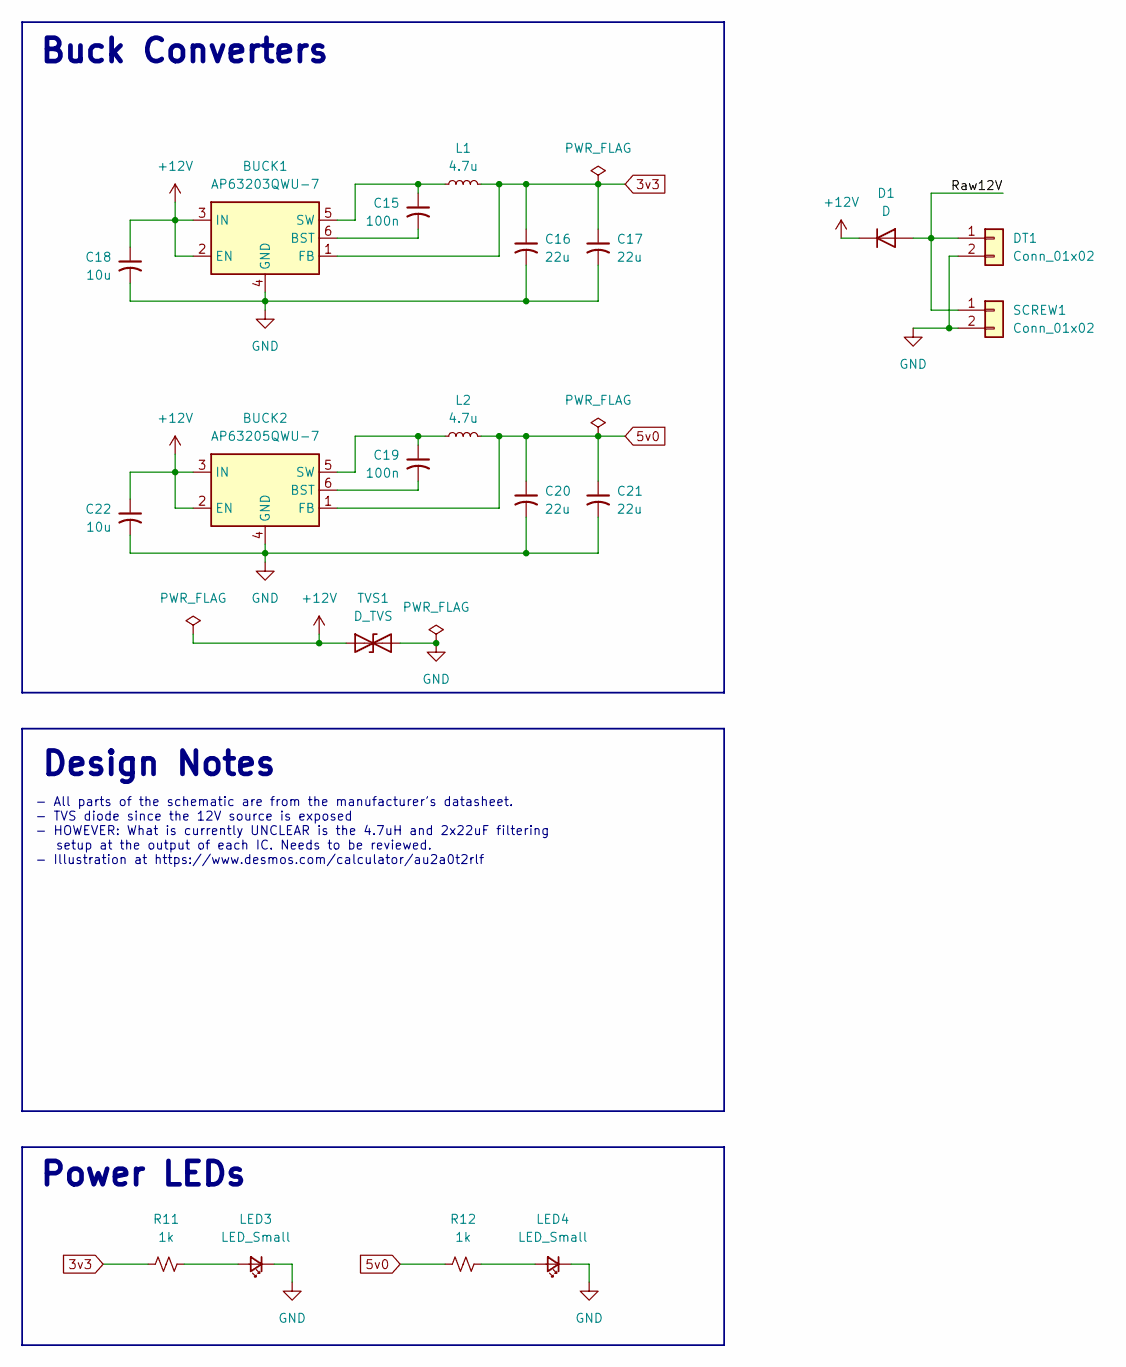
[picture p22: schematic Power.kicad_sch, CAN IO Board | Power]

Parts:
BUCK1: AP63203QWU-7; TSOT-23-6
BUCK2: AP63205QWU-7; TSOT-23-6
C15, C19: 100n; C_0603_1608Metric_Pad1.08x0.95mm_HandSolder
C16, C17, C20, C21: 22u; CP_Elec_4x4.5
C18, C22: 10u; C_0603_1608Metric_Pad1.08x0.95mm_HandSolder
D1: D; D_SMC_Handsoldering
DT1: Conn_01x02; TE_DTF13-2P
L1, L2: 4.7u; L_Axial_L7.0mm_D3.3mm_P5.08mm_Vertical_Fastron_MICC
LED3, LED4: LED_Small; LED_1206_3216Metric_Pad1.42x1.75mm_HandSolder
R11, R12: 1k; R_0603_1608Metric_Pad0.98x0.95mm_HandSolder
SCREW1: Conn_01x02; TerminalBlock_MaiXu_MX126-5.0-02P_1x02_P5.00mm
TVS1: D_TVS; D_SMA_Handsoldering

Connections:
3v3: BUCK1.1 (FB), C16.1, C17.1, L1.2, R11.1; also elsewhere on the board
5v0: BUCK2.1 (FB), C20.1, C21.1, L2.2, R12.1; also elsewhere on the board
+12V: BUCK1.2 (EN), BUCK1.3 (IN), BUCK2.2 (EN), BUCK2.3 (IN), C18.1, C22.1, D1.1 (K), TVS1.1 (A1); also elsewhere on the board
/Power/Raw12V: D1.2 (A), DT1.1, SCREW1.1
GND: BUCK1.4 (GND), BUCK2.4 (GND), C16.2, C17.2, C18.2, C20.2, C21.2, C22.2, DT1.2, LED3.1 (K), LED4.1 (K), SCREW1.2, TVS1.2 (A2); also elsewhere on the board
unnamed: BUCK1.6 (BST), C15.2
unnamed: BUCK1.5 (SW), C15.1, L1.1
unnamed: BUCK2.6 (BST), C19.2
unnamed: BUCK2.5 (SW), C19.1, L2.1
unnamed: LED3.2 (A), R11.2
unnamed: LED4.2 (A), R12.2

Notes on the sheet:
- All parts of the schematic are from the manufacturer's datasheet. - TVS diode since the 12V source is exposed - HOWEVER: What is currently UNCLEAR is the 4.7uH and 2x22uF filtering setup at the output of each IC. Needs to be reviewed. - Illustration at https://www.desmos.com/calculator/au2a0t2rlf
Buck Converters
Power LEDs
Design Notes

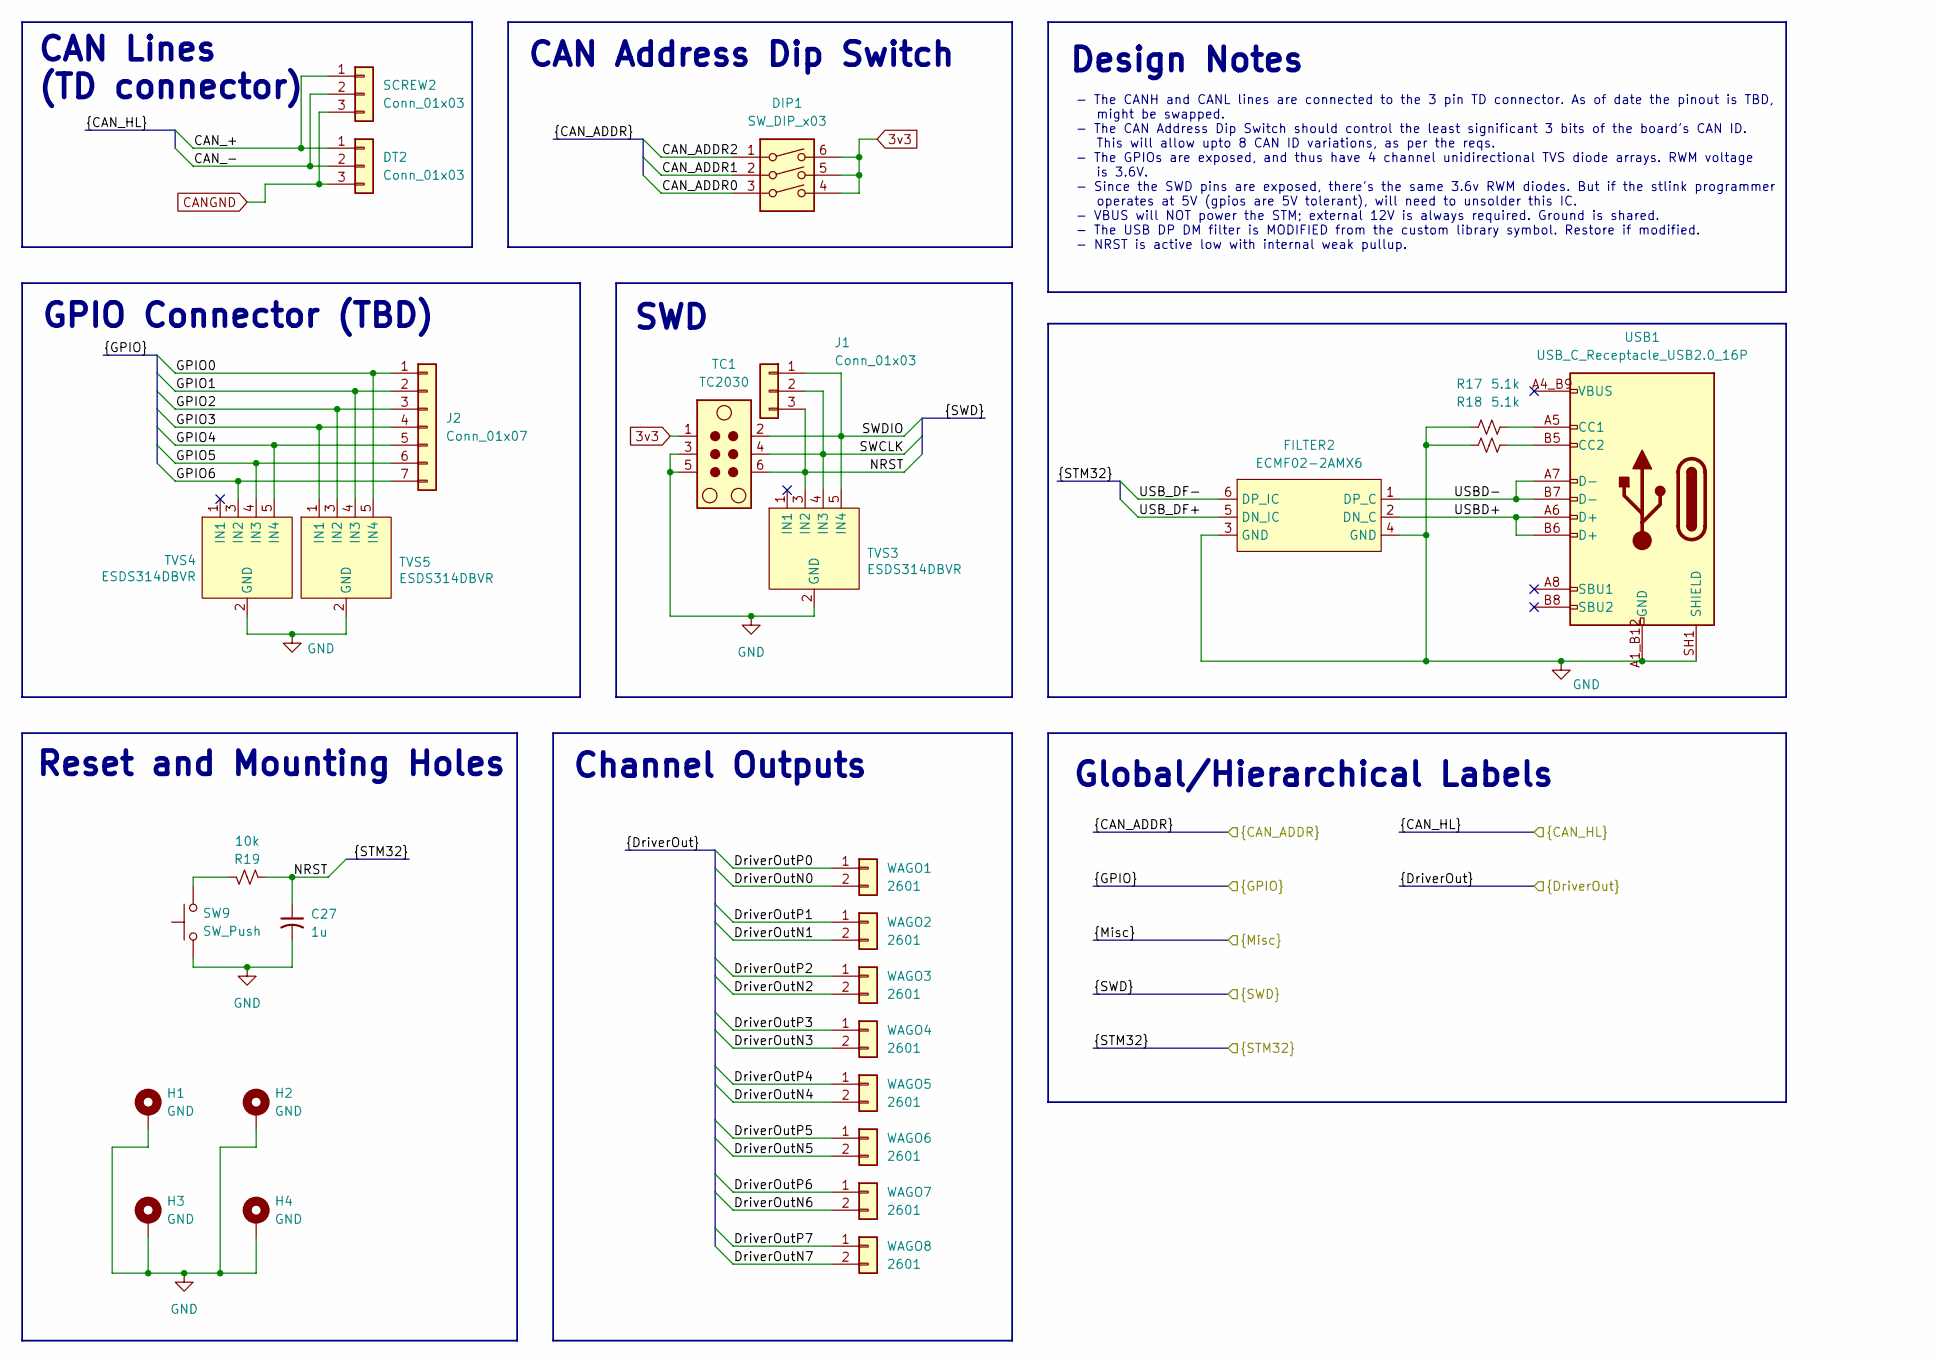
[picture p23: schematic Connectors.kicad_sch, CAN IO Board | Connectors]

Parts:
C27: 1u; C_0603_1608Metric_Pad1.08x0.95mm_HandSolder
DIP1: SW_DIP_x03; SW_DIP_SPSTx03_Slide_9.78x9.8mm_W7.62mm_P2.54mm
DT2: Conn_01x03; TE_DTF13-3P
FILTER2: ECMF02-2AMX6; ECMF02-2AMX6_QFN-6L
H1, H2, H3, H4: GND; MountingHole_3.5mm_Pad_Via
J1: Conn_01x03; PinHeader_1x03_P2.54mm_Vertical
J2: Conn_01x07; PinHeader_1x07_P2.54mm_Vertical
R17, R18: 5.1k; R_0603_1608Metric_Pad0.98x0.95mm_HandSolder
R19: 10k; R_0603_1608Metric_Pad0.98x0.95mm_HandSolder
SCREW2: Conn_01x03; TerminalBlock_MaiXu_MX126-5.0-03P_1x03_P5.00mm
SW9: SW_Push; SW_Push_1P1T_NO_CK_KSC7xxJ
TC1: TC2030; Tag-Connect_TC2030-IDC-NL_2x03_P1.27mm_Vertical
TVS3, TVS4, TVS5: ESDS314DBVR; SOT-23-5
USB1: USB_C_Receptacle_USB2.0_16P; SHOUHAN_TYPE-C_16PIN_2MD__073_
WAGO1, WAGO2, WAGO3, WAGO4, WAGO5, WAGO6, WAGO7, WAGO8: 2601; TerminalBlock_WAGO_2601-1102_1x02_P3.50mm_Horizontal

Connections:
3v3: DIP1.4, DIP1.5, DIP1.6, TC1.1; also elsewhere on the board
/CAN/CAN_+: DT2.1, SCREW2.1; also elsewhere on the board
/CAN/CAN_-: DT2.2, SCREW2.2; also elsewhere on the board
/Connectors/CAN_ADDR0: DIP1.3; also elsewhere on the board
/Connectors/CAN_ADDR1: DIP1.2; also elsewhere on the board
/Connectors/CAN_ADDR2: DIP1.1; also elsewhere on the board
/Connectors/DriverOutN0: WAGO1.2; also elsewhere on the board
/Connectors/DriverOutN1: WAGO2.2; also elsewhere on the board
/Connectors/DriverOutN2: WAGO3.2; also elsewhere on the board
/Connectors/DriverOutN3: WAGO4.2; also elsewhere on the board
/Connectors/DriverOutN4: WAGO5.2; also elsewhere on the board
/Connectors/DriverOutN5: WAGO6.2; also elsewhere on the board
/Connectors/DriverOutN6: WAGO7.2; also elsewhere on the board
/Connectors/DriverOutN7: WAGO8.2; also elsewhere on the board
/Connectors/DriverOutP0: WAGO1.1; also elsewhere on the board
/Connectors/DriverOutP1: WAGO2.1; also elsewhere on the board
/Connectors/DriverOutP2: WAGO3.1; also elsewhere on the board
/Connectors/DriverOutP3: WAGO4.1; also elsewhere on the board
/Connectors/DriverOutP4: WAGO5.1; also elsewhere on the board
/Connectors/DriverOutP5: WAGO6.1; also elsewhere on the board
/Connectors/DriverOutP6: WAGO7.1; also elsewhere on the board
/Connectors/DriverOutP7: WAGO8.1; also elsewhere on the board
/Connectors/GPIO0: J2.1, TVS5.5 (IN4); also elsewhere on the board
/Connectors/GPIO1: J2.2, TVS5.4 (IN3); also elsewhere on the board
/Connectors/GPIO2: J2.3, TVS5.3 (IN2); also elsewhere on the board
/Connectors/GPIO3: J2.4, TVS5.1 (IN1); also elsewhere on the board
/Connectors/GPIO4: J2.5, TVS4.5 (IN4); also elsewhere on the board
/Connectors/GPIO5: J2.6, TVS4.4 (IN3); also elsewhere on the board
/Connectors/GPIO6: J2.7, TVS4.3 (IN2); also elsewhere on the board
/Connectors/NRST: C27.1, J1.3, R19.1, TC1.6, TVS3.3 (IN2); also elsewhere on the board
/Connectors/SWCLK: J1.2, TC1.4, TVS3.4 (IN3); also elsewhere on the board
/Connectors/SWDIO: J1.1, TC1.2, TVS3.5 (IN4); also elsewhere on the board
/Connectors/USBD+: FILTER2.2 (DN_C), USB1.A6 (D+), USB1.B6 (D+)
/Connectors/USBD-: FILTER2.1 (DP_C), USB1.A7 (D-), USB1.B7 (D-)
/Connectors/USB_DF+: FILTER2.5 (DN_IC); also elsewhere on the board
/Connectors/USB_DF-: FILTER2.6 (DP_IC); also elsewhere on the board
CANGND: DT2.3, SCREW2.3; also elsewhere on the board
GND: C27.2, FILTER2.3 (GND), FILTER2.4 (GND), H1.1, H2.1, H3.1, H4.1, R17.1, R18.1, SW9.1, TC1.3, TC1.5, TVS3.2 (GND), TVS4.2 (GND), TVS5.2 (GND), USB1.A1_B12 (GND), USB1.B1_A12 (GND), USB1.SH1 (SHIELD), USB1.SH2 (SHIELD), USB1.SH3 (SHIELD), USB1.SH4 (SHIELD); also elsewhere on the board
unnamed: R19.2, SW9.2
unnamed: R17.2, USB1.A5 (CC1)
unnamed: R18.2, USB1.B5 (CC2)

Notes on the sheet:
CAN Lines (TD connector)
CAN Address Dip Switch
SWD
Reset and Mounting Holes
- The CANH and CANL lines are connected to the 3 pin TD connector. As of date the pinout is TBD, might be swapped. - The CAN Address Dip Switch should control the least significant 3 bits of the board's CAN ID. This will allow upto 8 CAN ID variations, as per the reqs. - The GPIOs are exposed, and 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
Channel Outputs
Global/Hierarchical Labels
Design Notes
GPIO Connector (TBD)

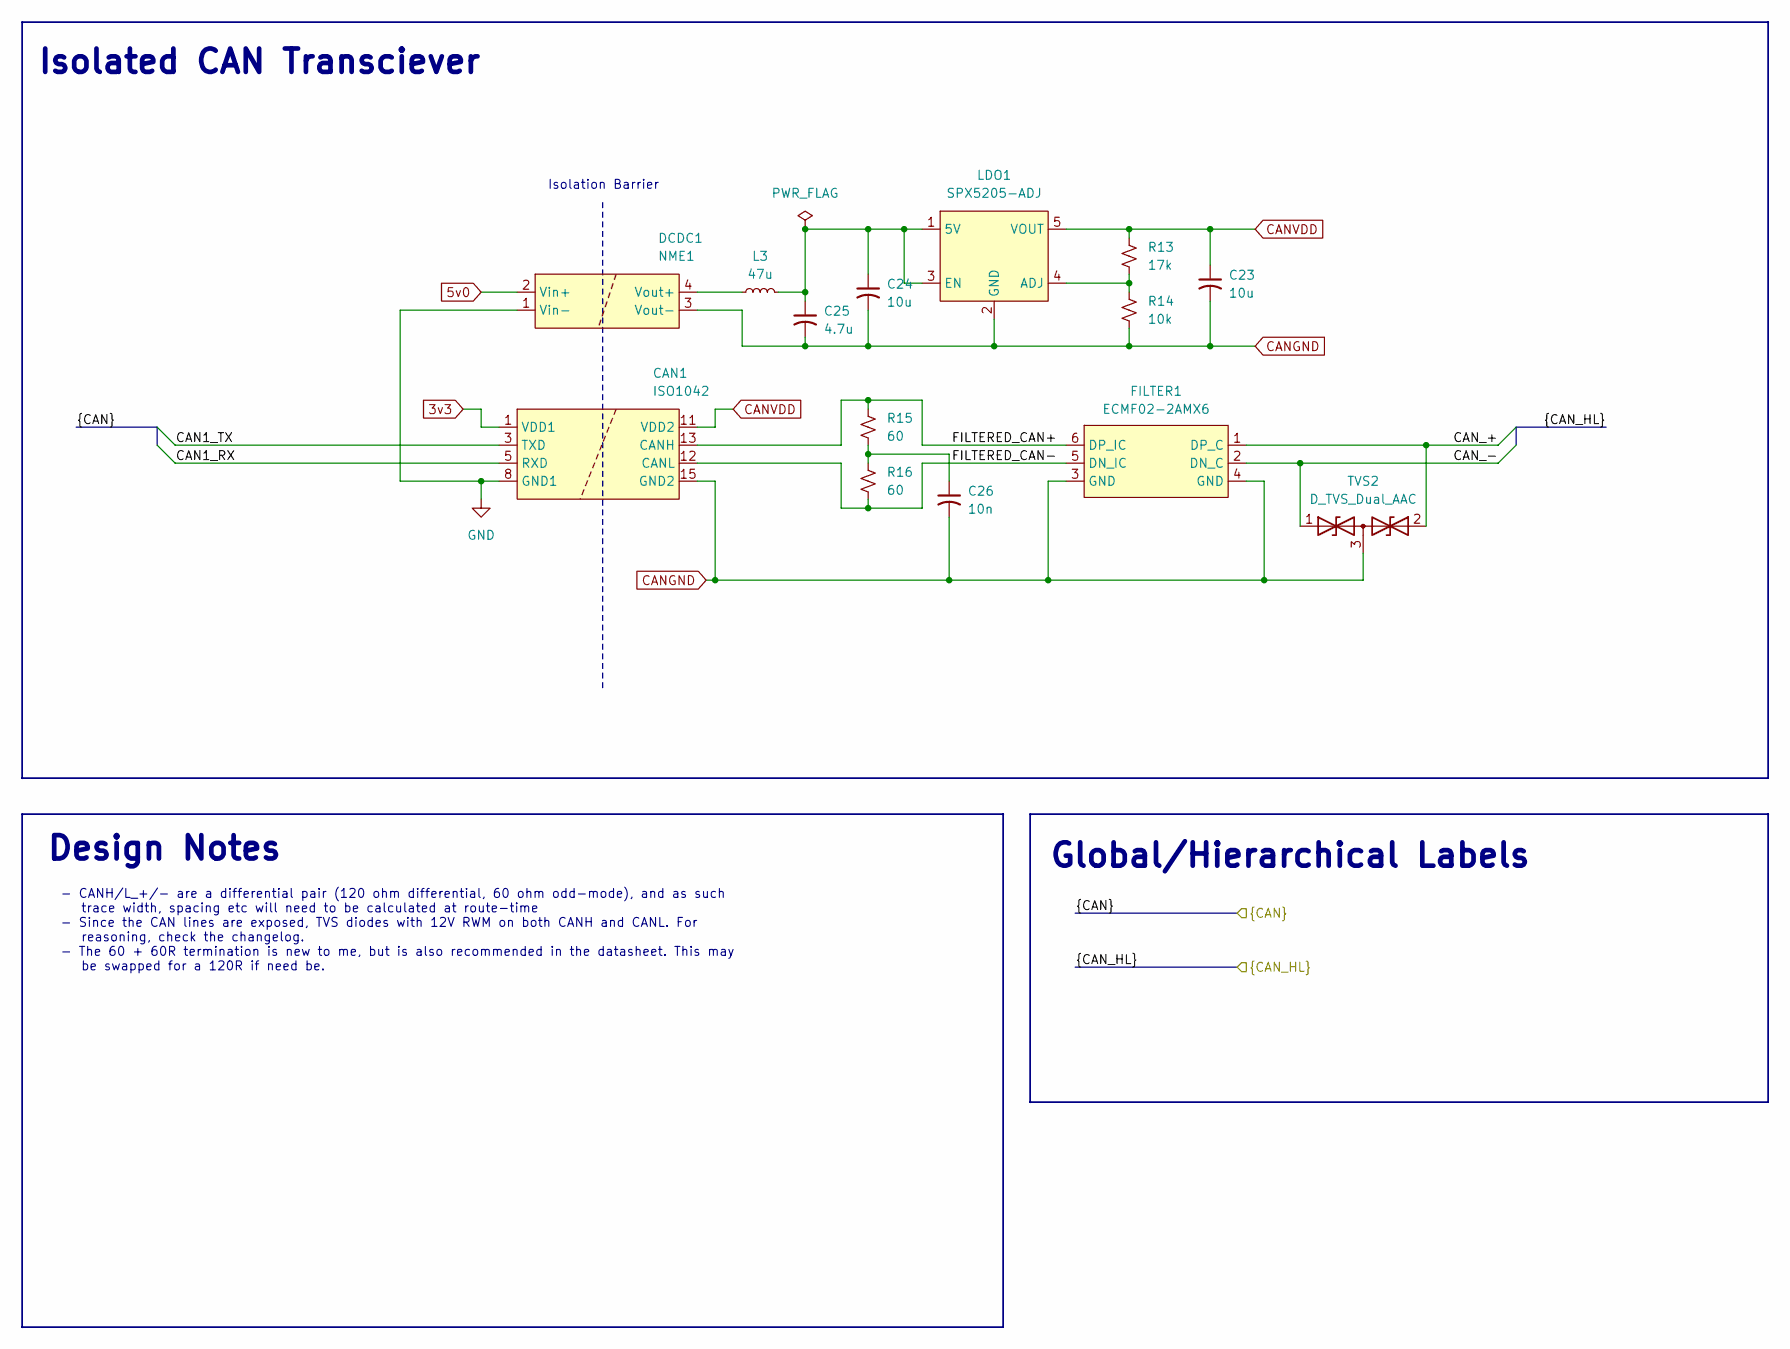
[picture p24: schematic CAN.kicad_sch, CAN IO Board | CAN Transciever]

Parts:
C23, C24: 10u; C_0603_1608Metric_Pad1.08x0.95mm_HandSolder
C25: 4.7u; CP_Elec_4x4.5
C26: 10n; C_0603_1608Metric_Pad1.08x0.95mm_HandSolder
CAN1: ISO1042; SOIC-16W_7.5x10.3mm_P1.27mm
DCDC1: NME1; NME1S
FILTER1: ECMF02-2AMX6; ECMF02-2AMX6_QFN-6L
L3: 47u; L_Axial_L7.0mm_D3.3mm_P5.08mm_Vertical_Fastron_MICC
LDO1: SPX5205-ADJ; SOT-23-5_HandSoldering
R13: 17k; R_0603_1608Metric_Pad0.98x0.95mm_HandSolder
R14: 10k; R_0603_1608Metric_Pad0.98x0.95mm_HandSolder
R15, R16: 60; R_0603_1608Metric_Pad0.98x0.95mm_HandSolder
TVS2: D_TVS_Dual_AAC; SOT-23

Connections:
3v3: CAN1.1 (VDD1); also elsewhere on the board
5v0: DCDC1.2 (Vin+); also elsewhere on the board
/CAN/CAN1_RX: CAN1.5 (RXD); also elsewhere on the board
/CAN/CAN1_TX: CAN1.3 (TXD); also elsewhere on the board
/CAN/CAN_+: FILTER1.1 (DP_C), TVS2.2 (A2); also elsewhere on the board
/CAN/CAN_-: FILTER1.2 (DN_C), TVS2.1 (A1); also elsewhere on the board
/CAN/FILTERED_CAN+: CAN1.13 (CANH), FILTER1.6 (DP_IC), R15.1
/CAN/FILTERED_CAN-: CAN1.12 (CANL), FILTER1.5 (DN_IC), R16.2
CANGND: C23.2, C24.2, C25.2, C26.2, CAN1.9 (GND2), CAN1.10 (GND2), CAN1.15 (GND2), DCDC1.3 (Vout-), FILTER1.3 (GND), FILTER1.4 (GND), LDO1.2 (GND), R14.2, TVS2.3 (common); also elsewhere on the board
CANVDD: C23.1, CAN1.11 (VDD2), CAN1.16 (VDD2), LDO1.5 (VOUT), R13.1
GND: CAN1.2 (GND1), CAN1.8 (GND1), DCDC1.1 (Vin-); also elsewhere on the board
unnamed: C26.1, R15.2, R16.1
unnamed: DCDC1.4 (Vout+), L3.1
unnamed: C24.1, C25.1, L3.2, LDO1.1 (5V), LDO1.3 (EN)
unnamed: LDO1.4 (ADJ), R13.2, R14.1

Notes on the sheet:
- CANH/L_+/- are a differential pair (120 ohm differential, 60 ohm odd-mode), and as such trace width, spacing etc will need to be calculated at route-time - Since the CAN lines are exposed, TVS diodes with 12V RWM on both CANH and CANL. For reasoning, check the changelog. - The 60 + 60R terminatio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
Isolation Barrier
Design Notes
Isolated CAN Transciever
Global/Hierarchical Labels
