NJIT-Solar-Car/canio/Hardware/Relay/CANIO-Board.kicad_pcb

## KiCad design Hardware/Relay/CANIO-Board.kicad_pcb (continued)

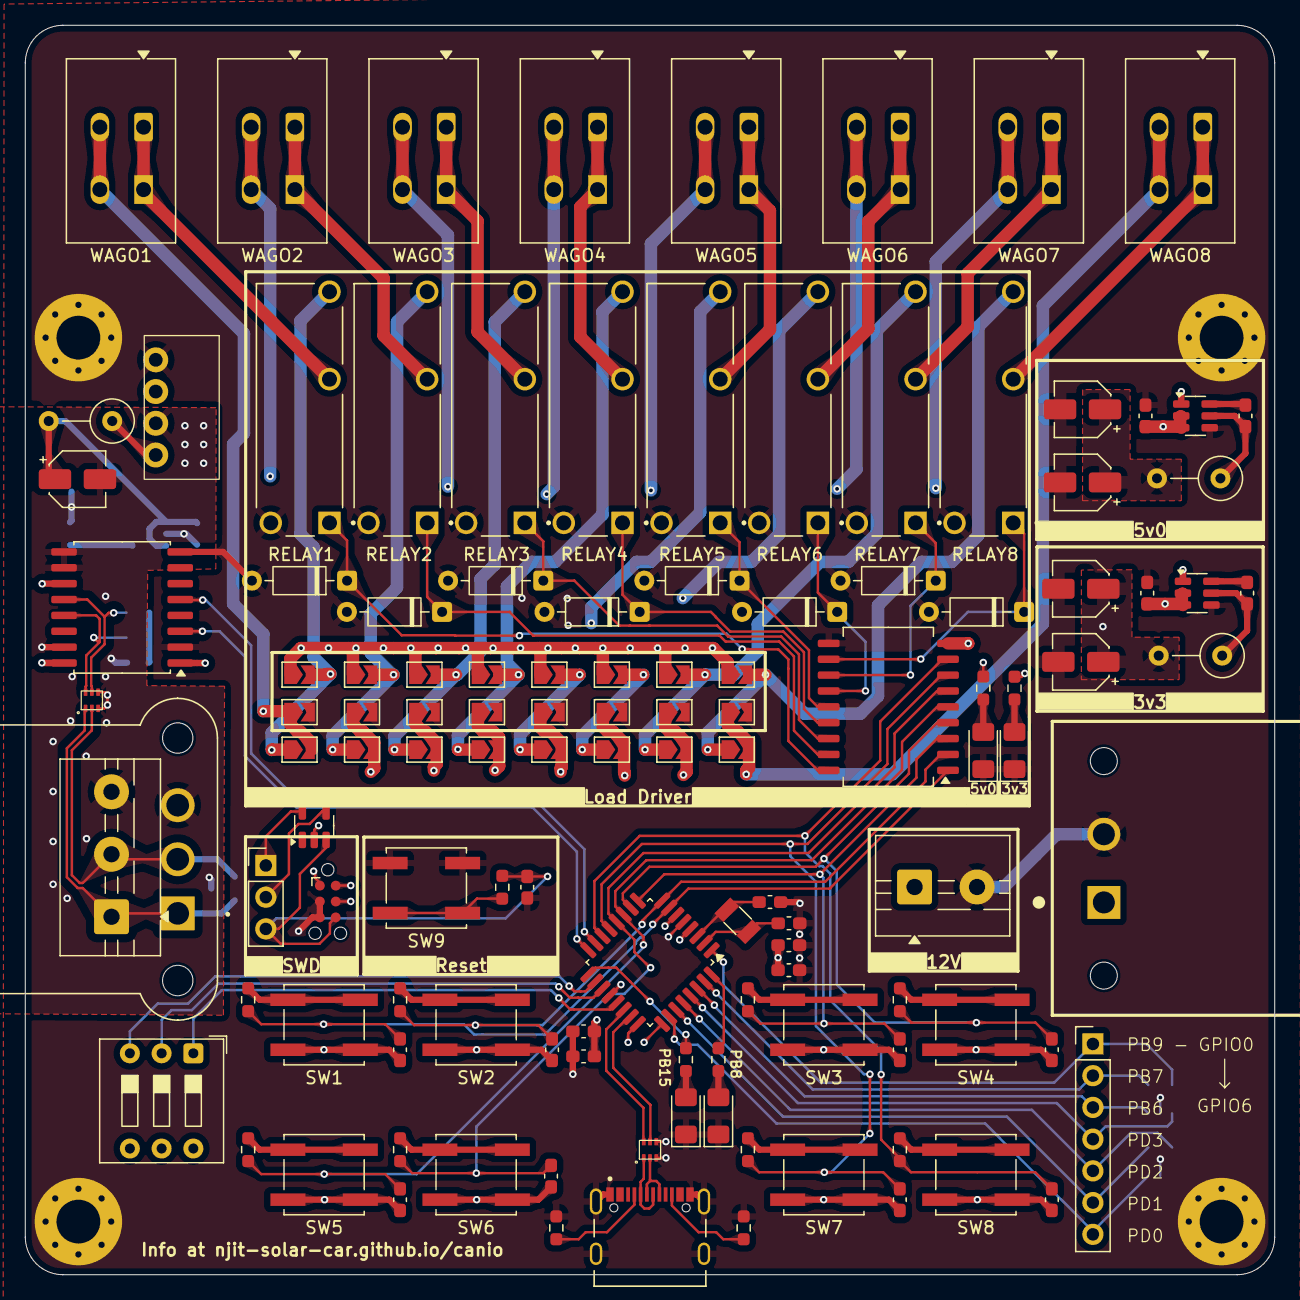
[picture p25: board CANIO-Board.kicad_pcb from above]

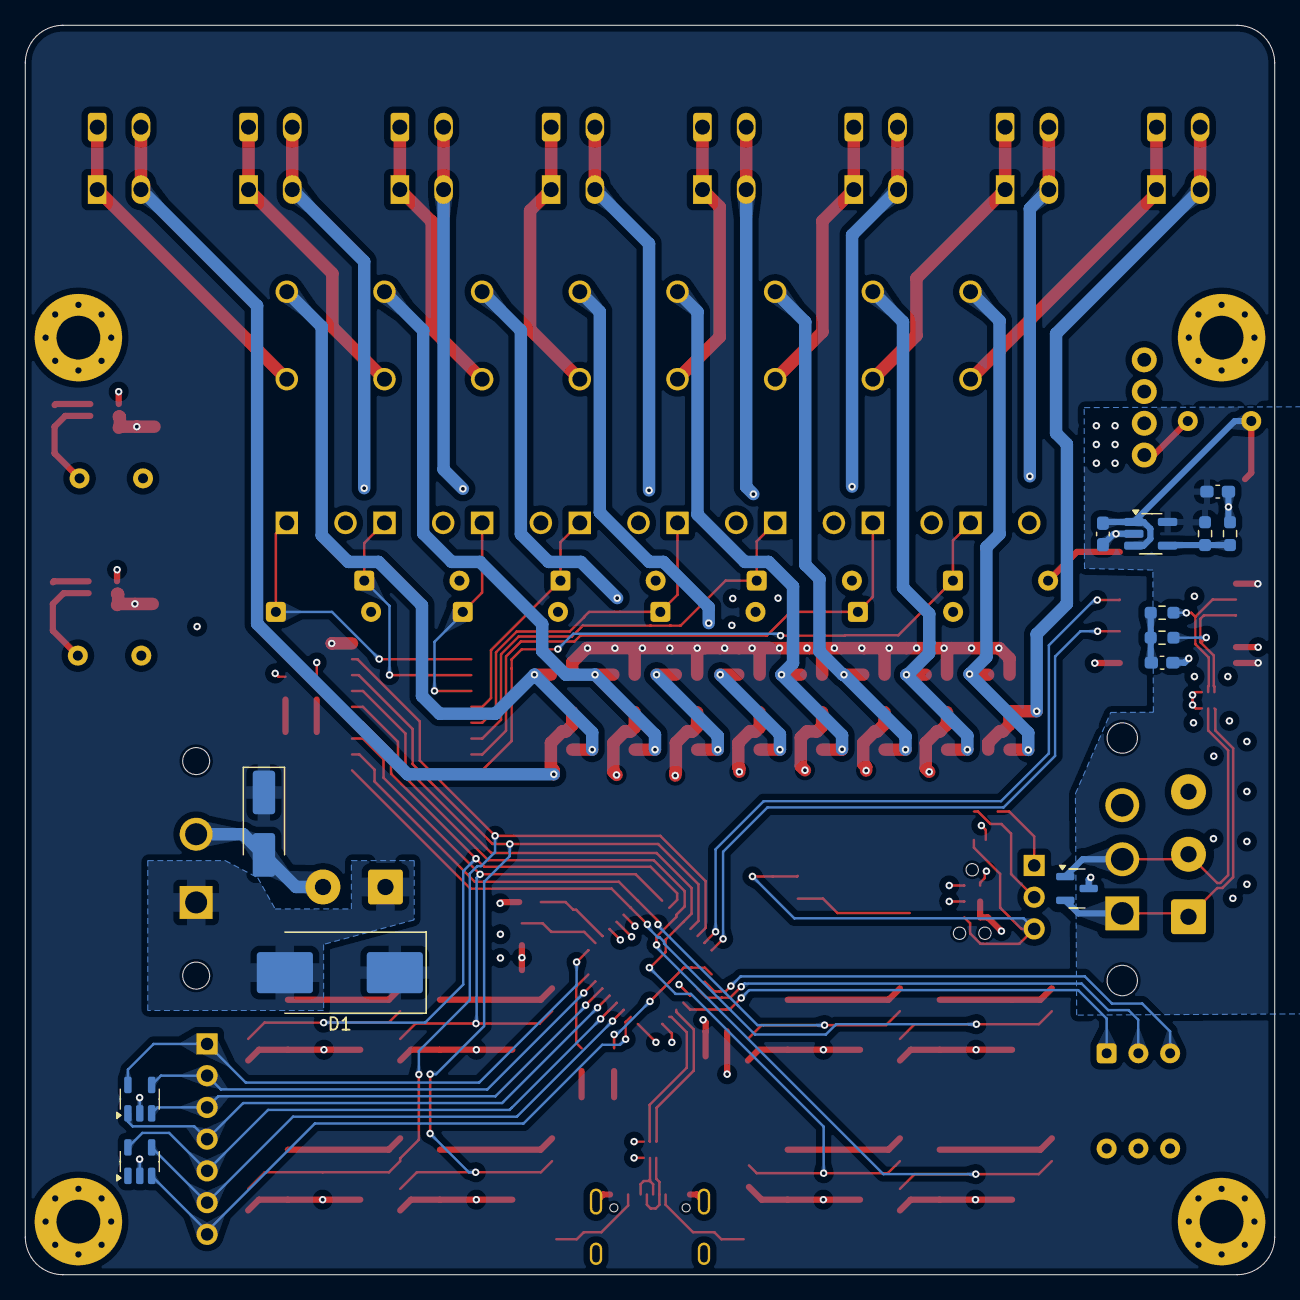
[picture p26: board CANIO-Board.kicad_pcb from below]

Board: 4 copper layers, 100.0 x 100.0 mm, 139 parts (13 on the bottom side), 97 nets.
