NJIT-Solar-Car/canio/Software/Core/Inc/main.h

#define GPIO0_Pin GPIO_PIN_9
#define GPIO0_GPIO_Port GPIOB
#define HighChan0_Pin GPIO_PIN_0
#define HighChan0_GPIO_Port GPIOA
#define HighChan1_Pin GPIO_PIN_1
#define HighChan1_GPIO_Port GPIOA
#define HighChan2_Pin GPIO_PIN_2
#define HighChan2_GPIO_Port GPIOA
#define HighChan3_Pin GPIO_PIN_3
#define HighChan3_GPIO_Port GPIOA
#define HighChan4_Pin GPIO_PIN_4
#define HighChan4_GPIO_Port GPIOA
#define HighChan5_Pin GPIO_PIN_5
#define HighChan5_GPIO_Port GPIOA
#define HighChan6_Pin GPIO_PIN_6
#define HighChan6_GPIO_Port GPIOA
#define HighChan7_Pin GPIO_PIN_7
#define HighChan7_GPIO_Port GPIOA
#define FAULT_Pin GPIO_PIN_15
#define FAULT_GPIO_Port GPIOB
#define CAN_ADDR0_Pin GPIO_PIN_8
#define CAN_ADDR0_GPIO_Port GPIOA
#define CAN_ADDR1_Pin GPIO_PIN_9
#define CAN_ADDR1_GPIO_Port GPIOA
#define CAN_ADDR2_Pin GPIO_PIN_10
#define CAN_ADDR2_GPIO_Port GPIOA
#define GPIO6_Pin GPIO_PIN_0
#define GPIO6_GPIO_Port GPIOD
#define GPIO5_Pin GPIO_PIN_1
#define GPIO5_GPIO_Port GPIOD
#define GPIO4_Pin GPIO_PIN_2
#define GPIO4_GPIO_Port GPIOD
#define GPIO3_Pin GPIO_PIN_3
#define GPIO3_GPIO_Port GPIOD
#define GPIO2_Pin GPIO_PIN_6
#define GPIO2_GPIO_Port GPIOB
#define GPIO1_Pin GPIO_PIN_7
#define GPIO1_GPIO_Port GPIOB
#define HEARTBEAT_Pin GPIO_PIN_8
#define HEARTBEAT_GPIO_Port GPIOB
