NJIT-Solar-Car/canio/(commit log)

2026-06-08 Added initial provided schematics
    [CANIO-Board.kicad_pcb, CANIO-Board.kicad_sch]
2026-06-08 Restructured the schematic a little for modularity
    - Gave each sub-component its own hierarchical sheet
    - Placed the current schematic into a temporary sheet called 'old'.
    Gonna adapt everything and double check while doing so.
    - Will make one commit with adapted schematic.
    [CAN.kicad_sch, CANIO-Board.kicad_sch, Connectors.kicad_sch, Load_Driver.kicad_sch, Power.kicad_sch, STM32G0B1.kicad_sch, old.kicad_sch]
2026-06-08 added some more datasheets and a button debouncing AN from TI
2026-06-09 Added Relay Driver schematics
    - added the ICs, relay sockets, etc
    [CANIO-Board.kicad_sch, Load_Driver.kicad_sch, Relays.kicad_sch, TPL7407LADR.step, VCF4-1000.step]
2026-06-09 Finished the ISOW1044 Schematic
    - Ported over Kostadin's schematic
    [CAN.kicad_sch, CANIO-Board.kicad_sch, Connectors.kicad_sch, Load_Driver.kicad_sch, Power.kicad_sch, STM32G0B1.kicad_sch]
2026-06-09 Updated the IOC. Final IOC unless any schematic changes have to be made
2026-06-09 Finished final touches on schematic.
    - Schematic is complete (NOT yet checked by Yassa/Val)
    - ERC check is complete, understandable errors excused w/ comments
    - Final schematic formatting complete
    [CAN.kicad_sch, CANIO-Board.kicad_sch, Connectors.kicad_sch, Load_Driver.kicad_sch, Power.kicad_sch, STM32G0B1.kicad_sch, old.kicad_sch]
2026-06-09 Added schematic pdf
2026-06-10 Added BOM v1. INCOMPLETE!!!
    [BOM.csv]
2026-06-10 Replaced the ISOW1044 CAN Transceiver with the ISO1042 + isolated DC-DC and LDO
    [CAN.kicad_sch, Connectors.kicad_sch, Load_Driver.kicad_sch, Power.kicad_sch, STM32G0B1.kicad_sch]
2026-06-11 Updated the USB-C connector from 14 pin to 16 pin
    [CAN.kicad_sch, Connectors.kicad_sch, STM32G0B1.kicad_sch]
2026-06-11 Replaced G0B1KET6 with KET6N in schematic
    - Updated the schematic with new symbol and pinout.
    - Updated the rest of the schematic with all resulting changes
    - This includes the 8 output channels, 7 GPIOs, and slightly
    different WAGO connector configuration.
    [CAN.kicad_sch, Connectors.kicad_sch, Load_Driver.kicad_sch, Power.kicad_sch, STM32G0B1.kicad_sch]
2026-06-11 Made the common mode choke footprint
2026-06-11 Replaced buck converters with drop in replacements
    [Power.kicad_sch]
2026-06-15 Finished the board
    - Board layout and routing is finished. Need to fix ~30 ERC errors and
    add thorough notes throughout, but otherwise that's it.
    - Once ERC errors are resolved, will post BOM and Gerbers as a release.
    [2601-1102.stp, CAN.kicad_sch, CANIO-Board.kicad_pcb, CANIO-Board.kicad_sch, Connectors.kicad_sch, Load_Driver.kicad_sch, NME1S.FCStd, NME1S.step]
2026-06-15 Fixed ERC errors
    [CANIO-Board.kicad_pcb]
2026-06-15 Updated schematic and layout PDFs
2026-06-16 final changes on pcb
    [BOM.csv, CANIO-Board.kicad_pcb, Power.kicad_sch]
2026-06-16 added gerbers, drill files, and BOM
    [CANIO-Board-B_Cu.gbl, CANIO-Board-B_Mask.gbs, CANIO-Board-B_Paste.gbp, CANIO-Board-B_Silkscreen.gbo, CANIO-Board-Edge_Cuts.gm1, CANIO-Board-F_Cu.gtl, CANIO-Board-F_Mask.gts, CANIO-Board-F_Paste.gtp]
2026-06-16 Added the BOM
    [CANIO_Relay_BOM.csv]
2026-06-16 moved folders
    [2601-1102.stp, CAN.kicad_sch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]
2026-06-18 Update README with project details
    Added project details about the CAN I/O driver board functionality.
2026-07-13 fixed some small issues w/ the code
    [main.c, relay.c, relay.h]
