NJIT-Solar-Car/canio/(notices)

Notices in the files:
Software/Core/Inc/main.h:
Copyright (c) 2026 STMicroelectronics.
All rights reserved.
This software is licensed under terms that can be found in the LICENSE file
Hardware/Relay/3DModels/2601-1102.stp:
author */ ('License CC BY-ND 4.0'),
